joebritt/luma1/README.md

# Luma-1
A modern re-implementation of the classic LM-1 Drum Computer.

See Luma-1 User Guide [here](https://docs.google.com/document/d/1ew5HF2rmsIb3FmjGhrn8vHP6tWtrs4gh6rTB0z4mO2c/edit?usp=sharing).

See Luma-1 Firmware Architecture Overview [here](https://docs.google.com/document/d/17OXfVWuMG1HZEo0KaN4xHhIkEzbQIpoH/edit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).

<p align="middle">
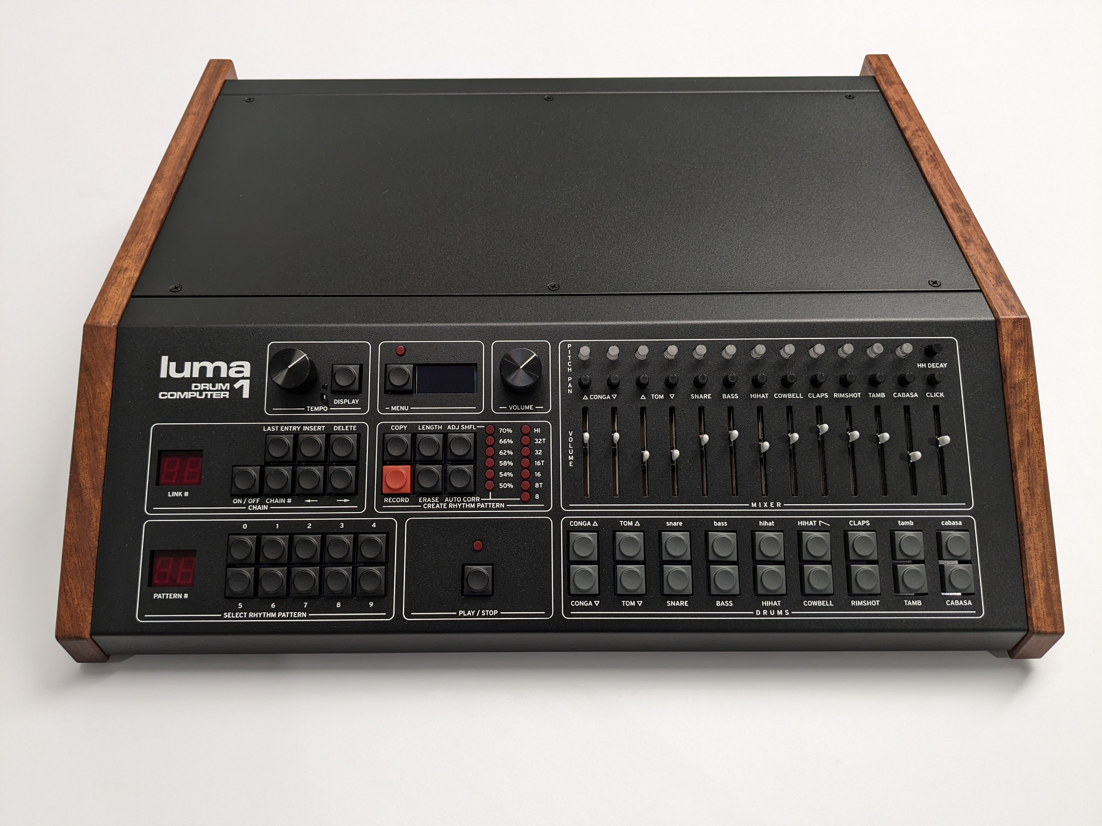
[picture p1: Luma-1 Pics/Luma-1_Bubinga_Front.jpg]
Luma-1
  
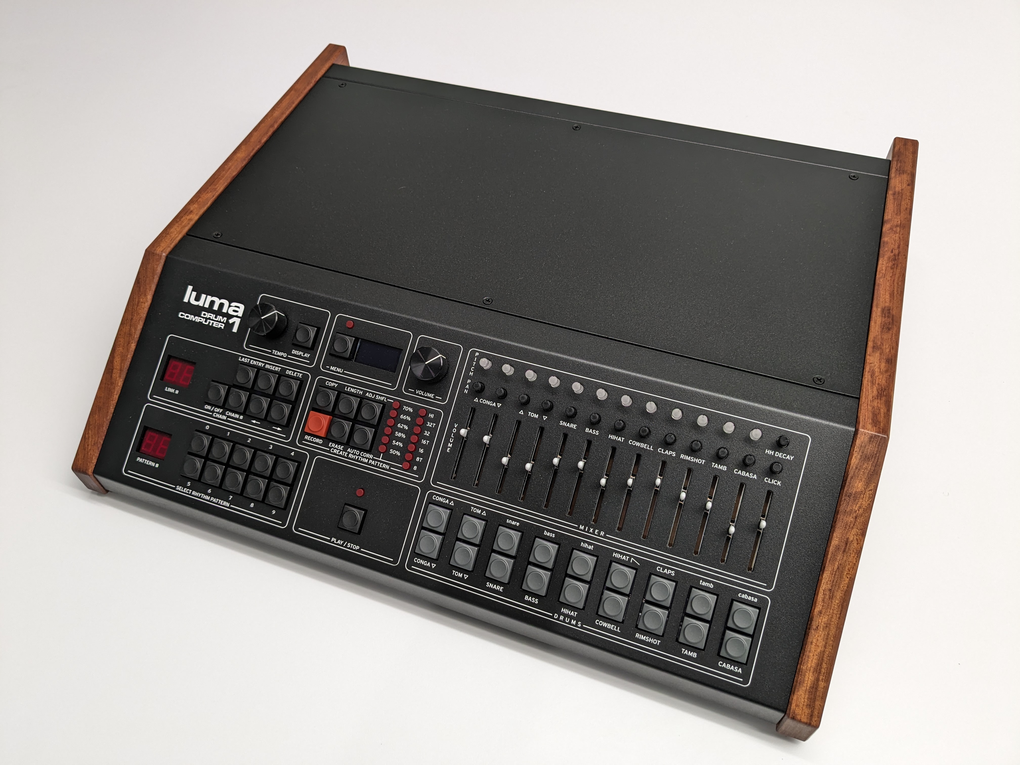
[picture p2: Luma-1 Pics/Luma-1_Bubinga_right.jpg]
Luma-1
  
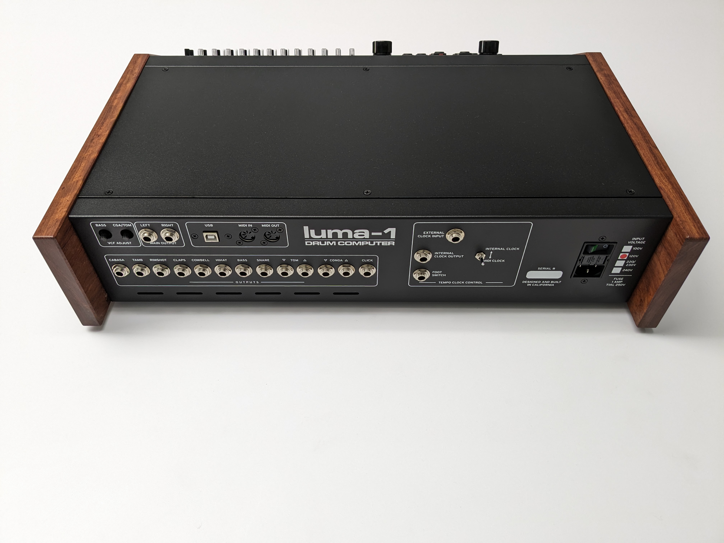
[picture p3: Luma-1 Pics/Luma-1_Bubinga_Rear.jpg]
Luma-1
  
</p>
