joebritt/luma1/Luma-1 Pics/Luma-1_Bubinga_Open.jpg

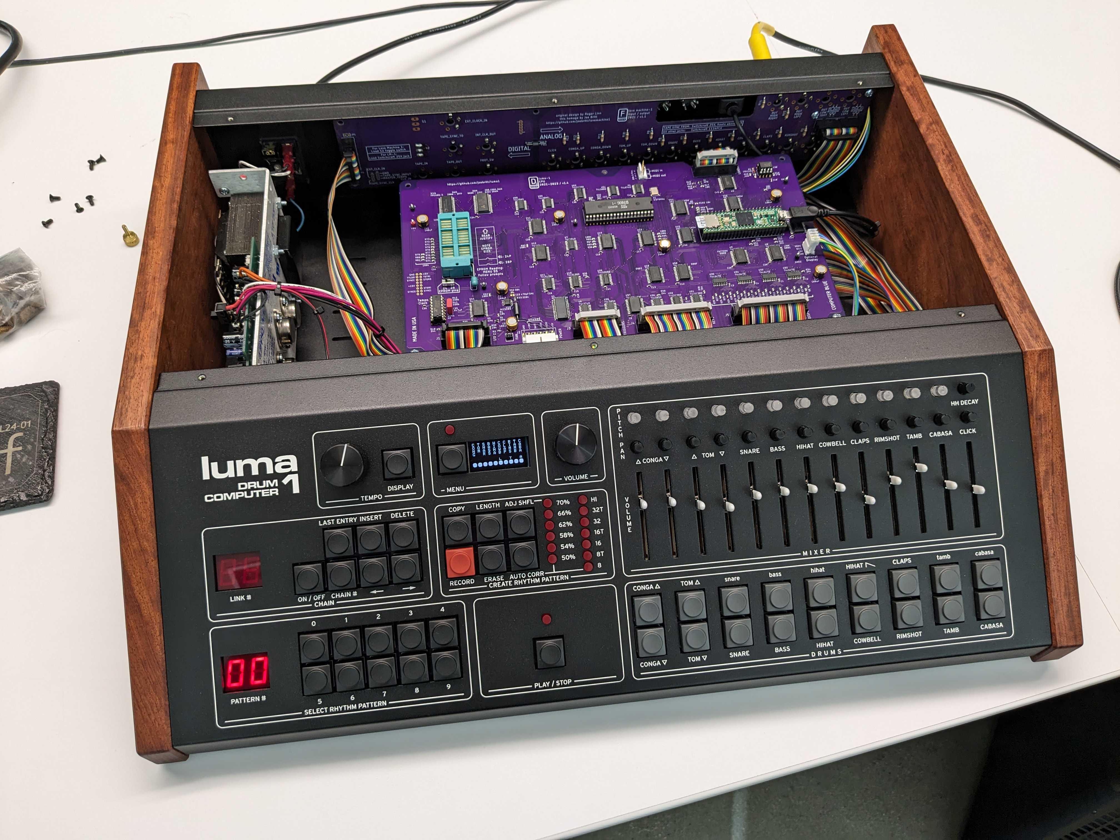
Luma-1 Pics/Luma-1_Bubinga_Open.jpg
