joebritt/luma1/Luma-1 Pics/Luma-1_LM-1_Together.jpg

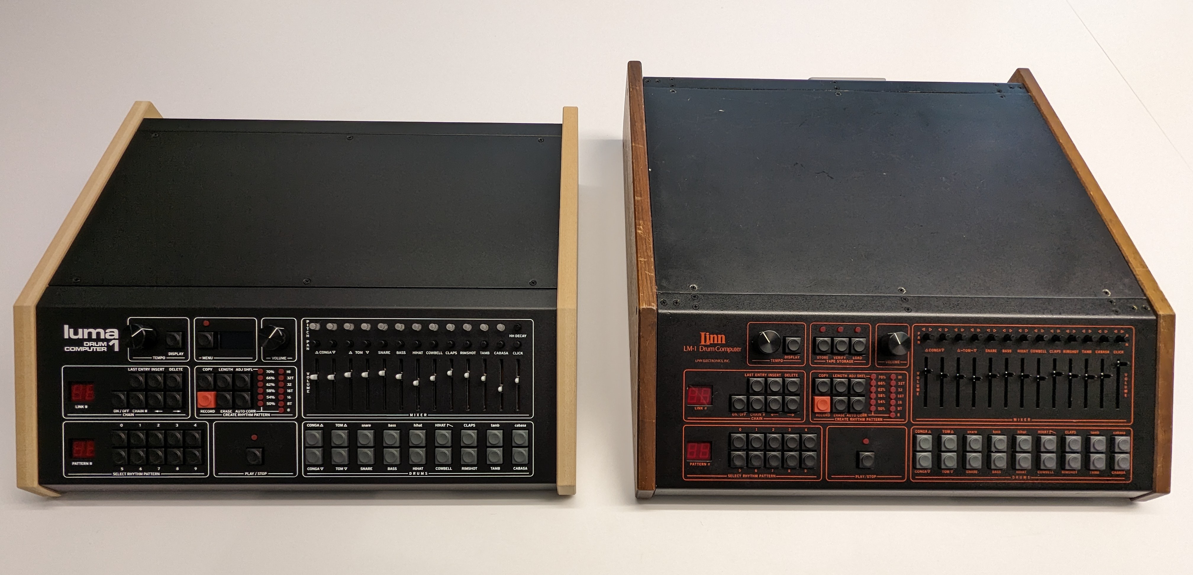
Luma-1 Pics/Luma-1_LM-1_Together.jpg
