joebritt/luma1/Schematics/luma-1_release_17Jan2024/luma1_D2_41.pdf

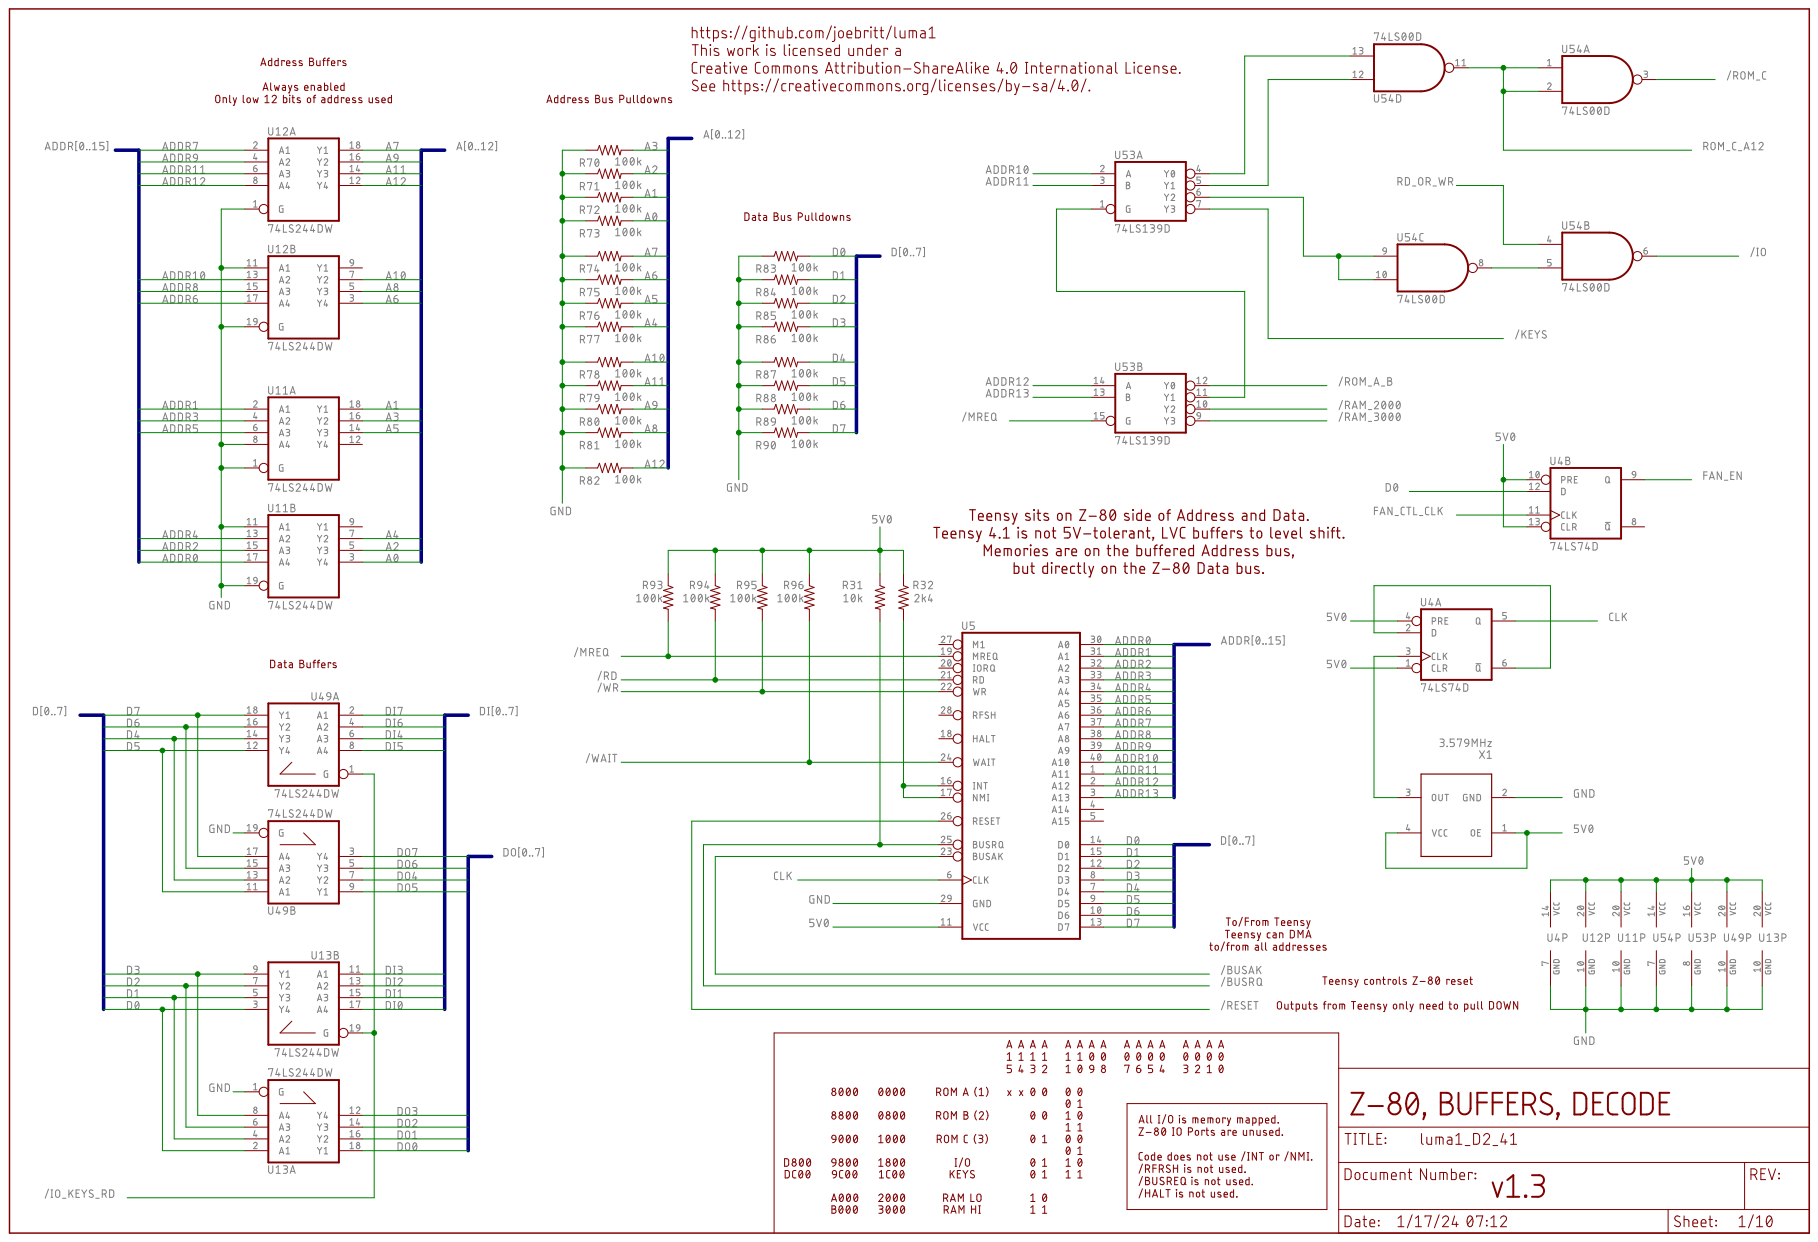
[picture p7: page 1]

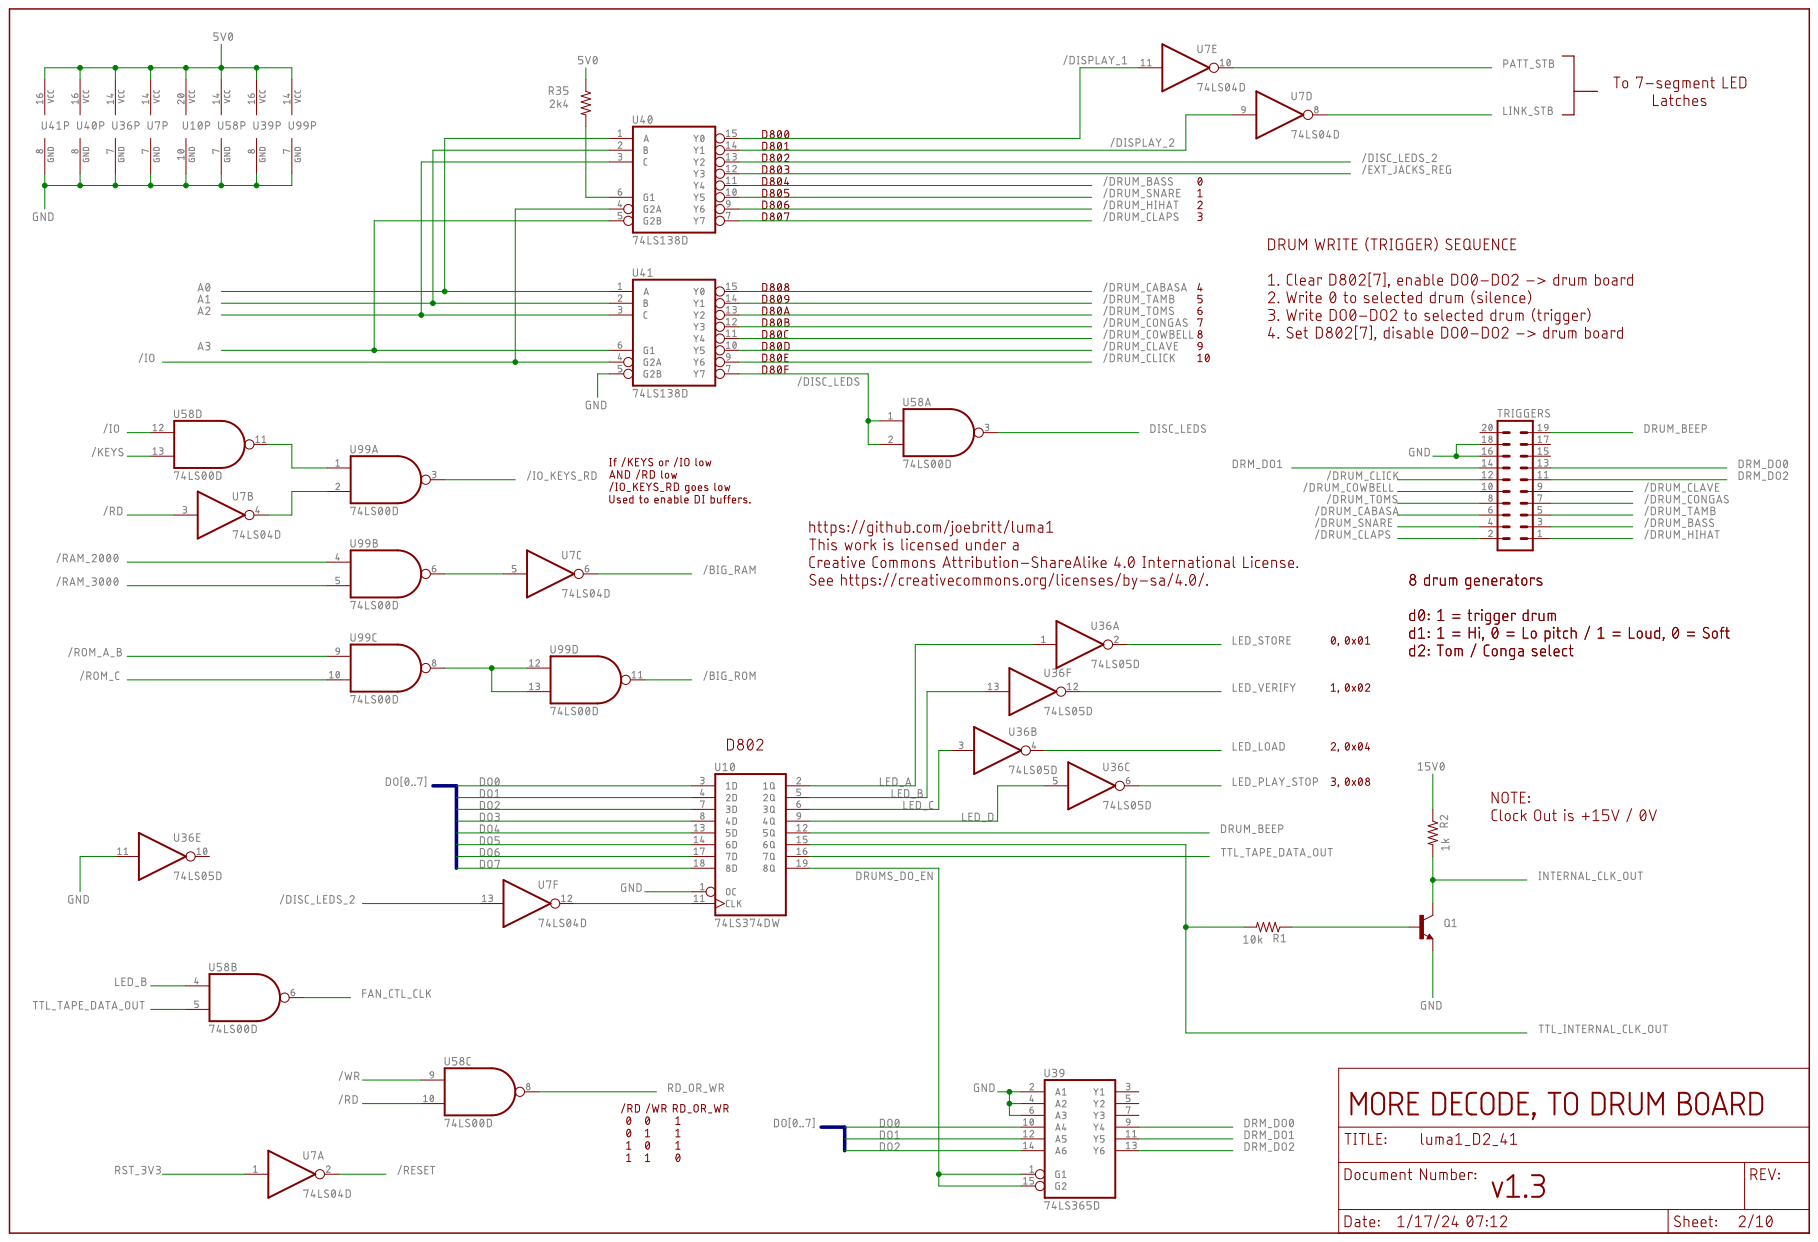
[picture p8: page 2]

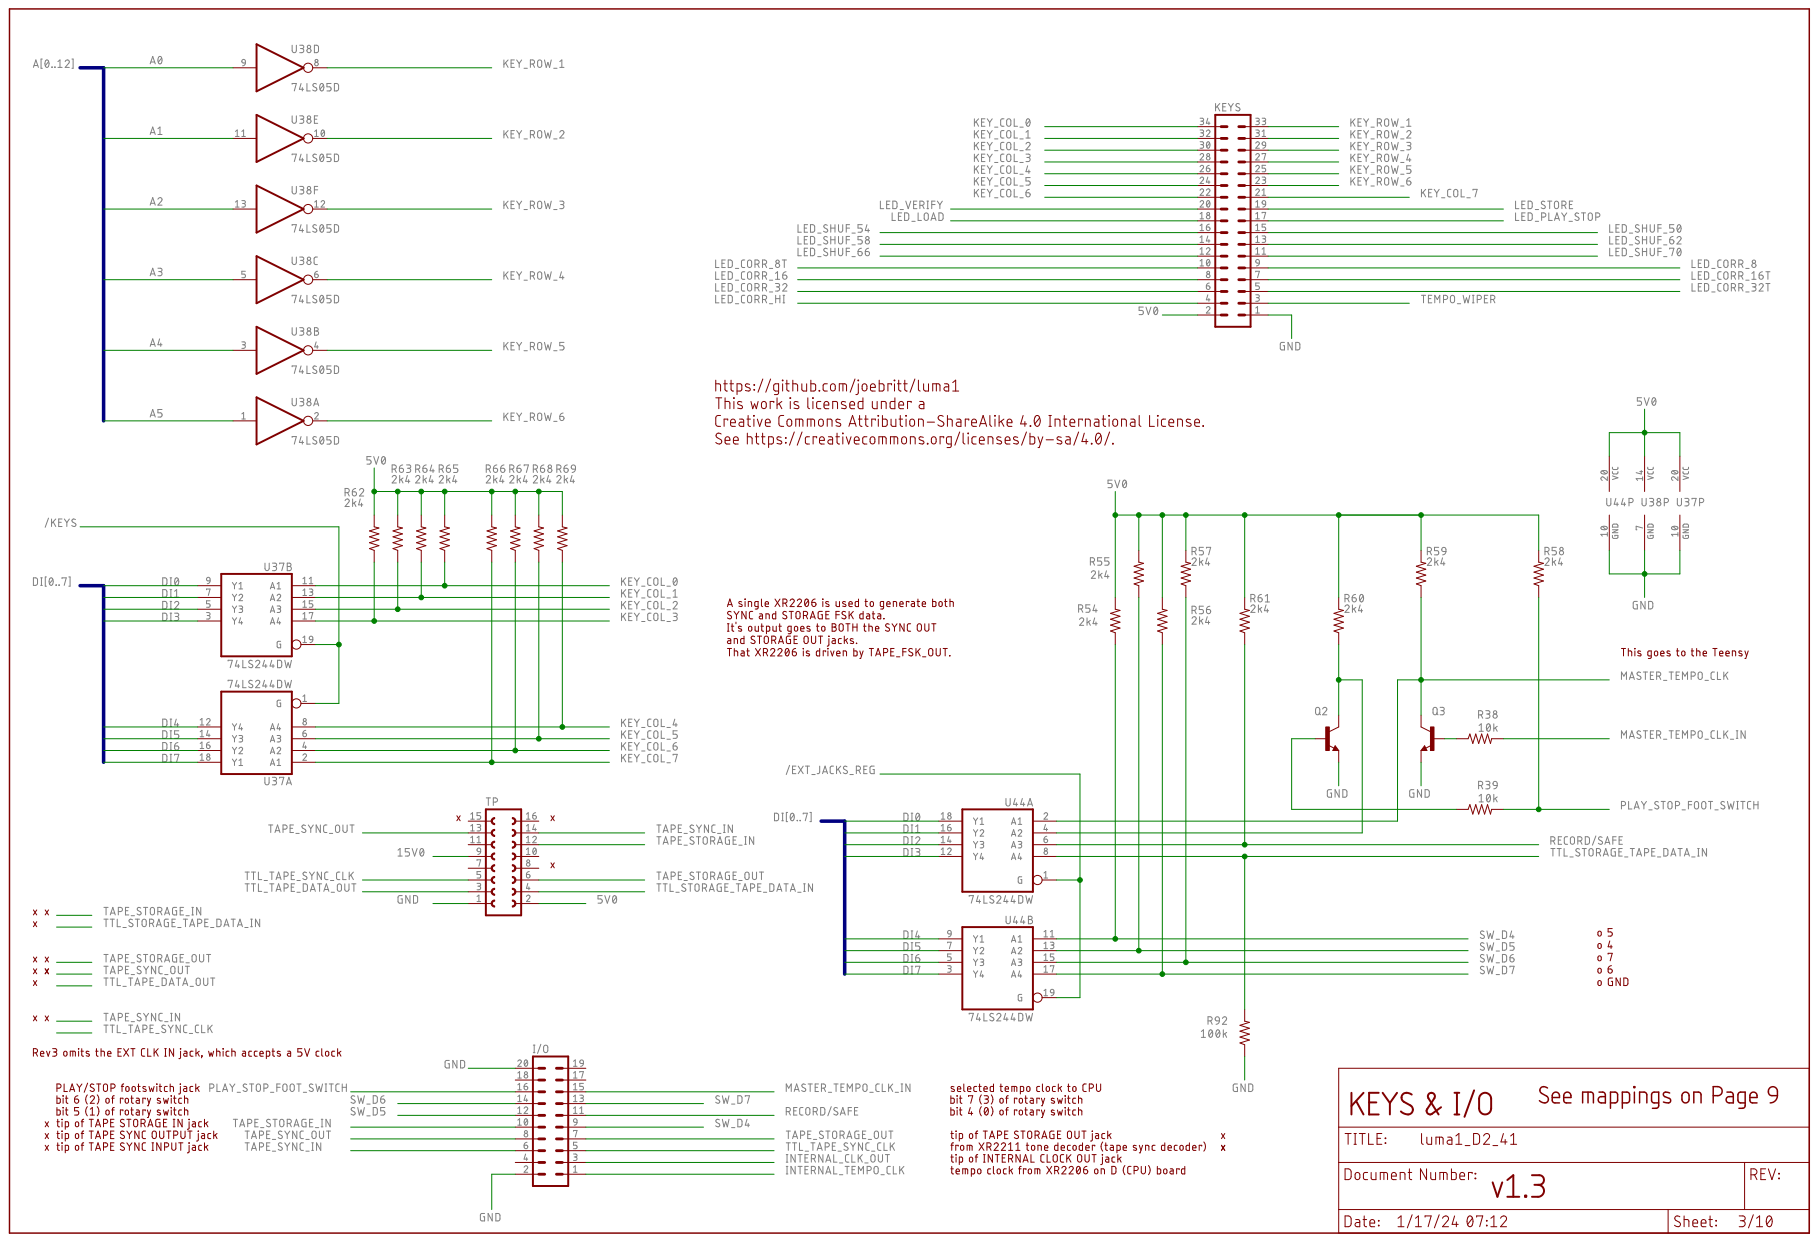
[picture p9: page 3]

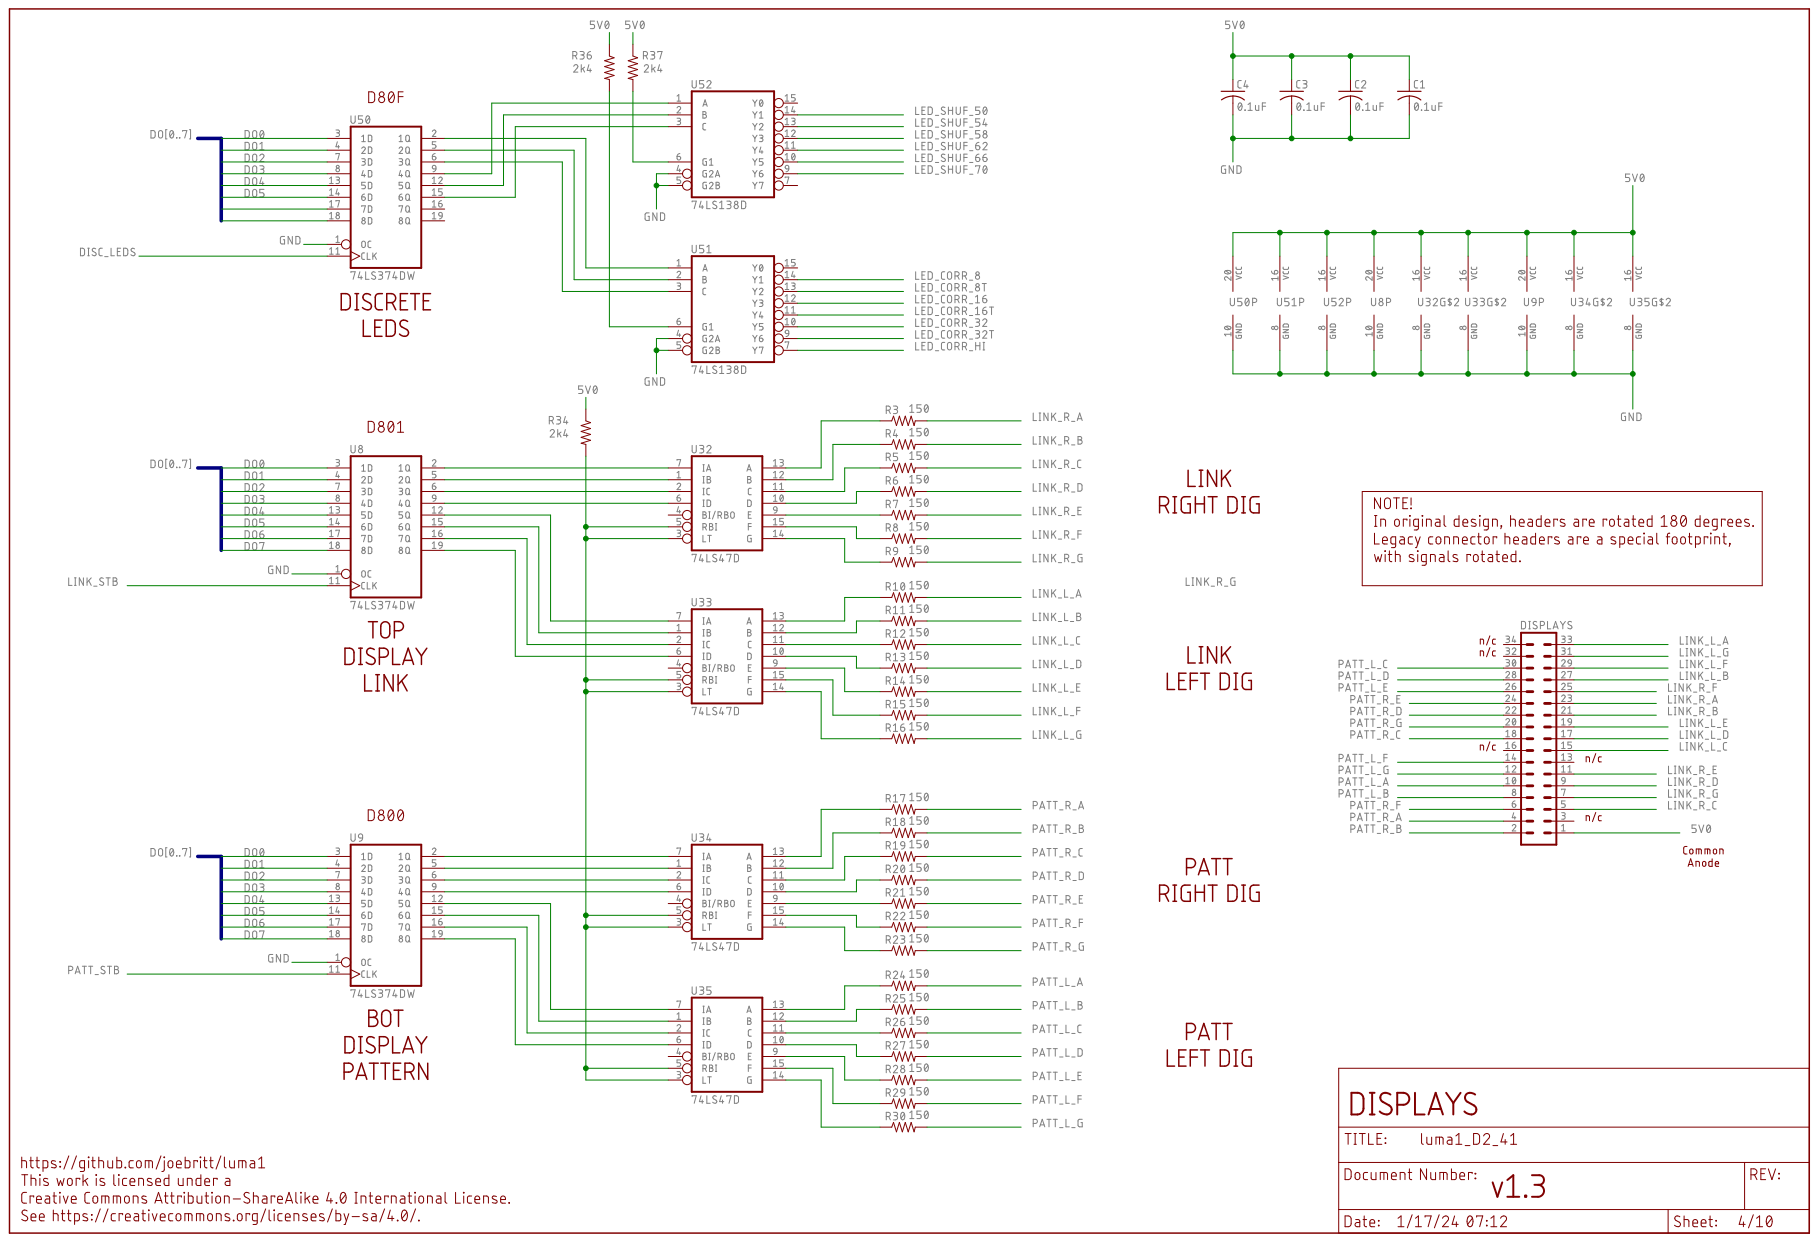
[picture p10: page 4]

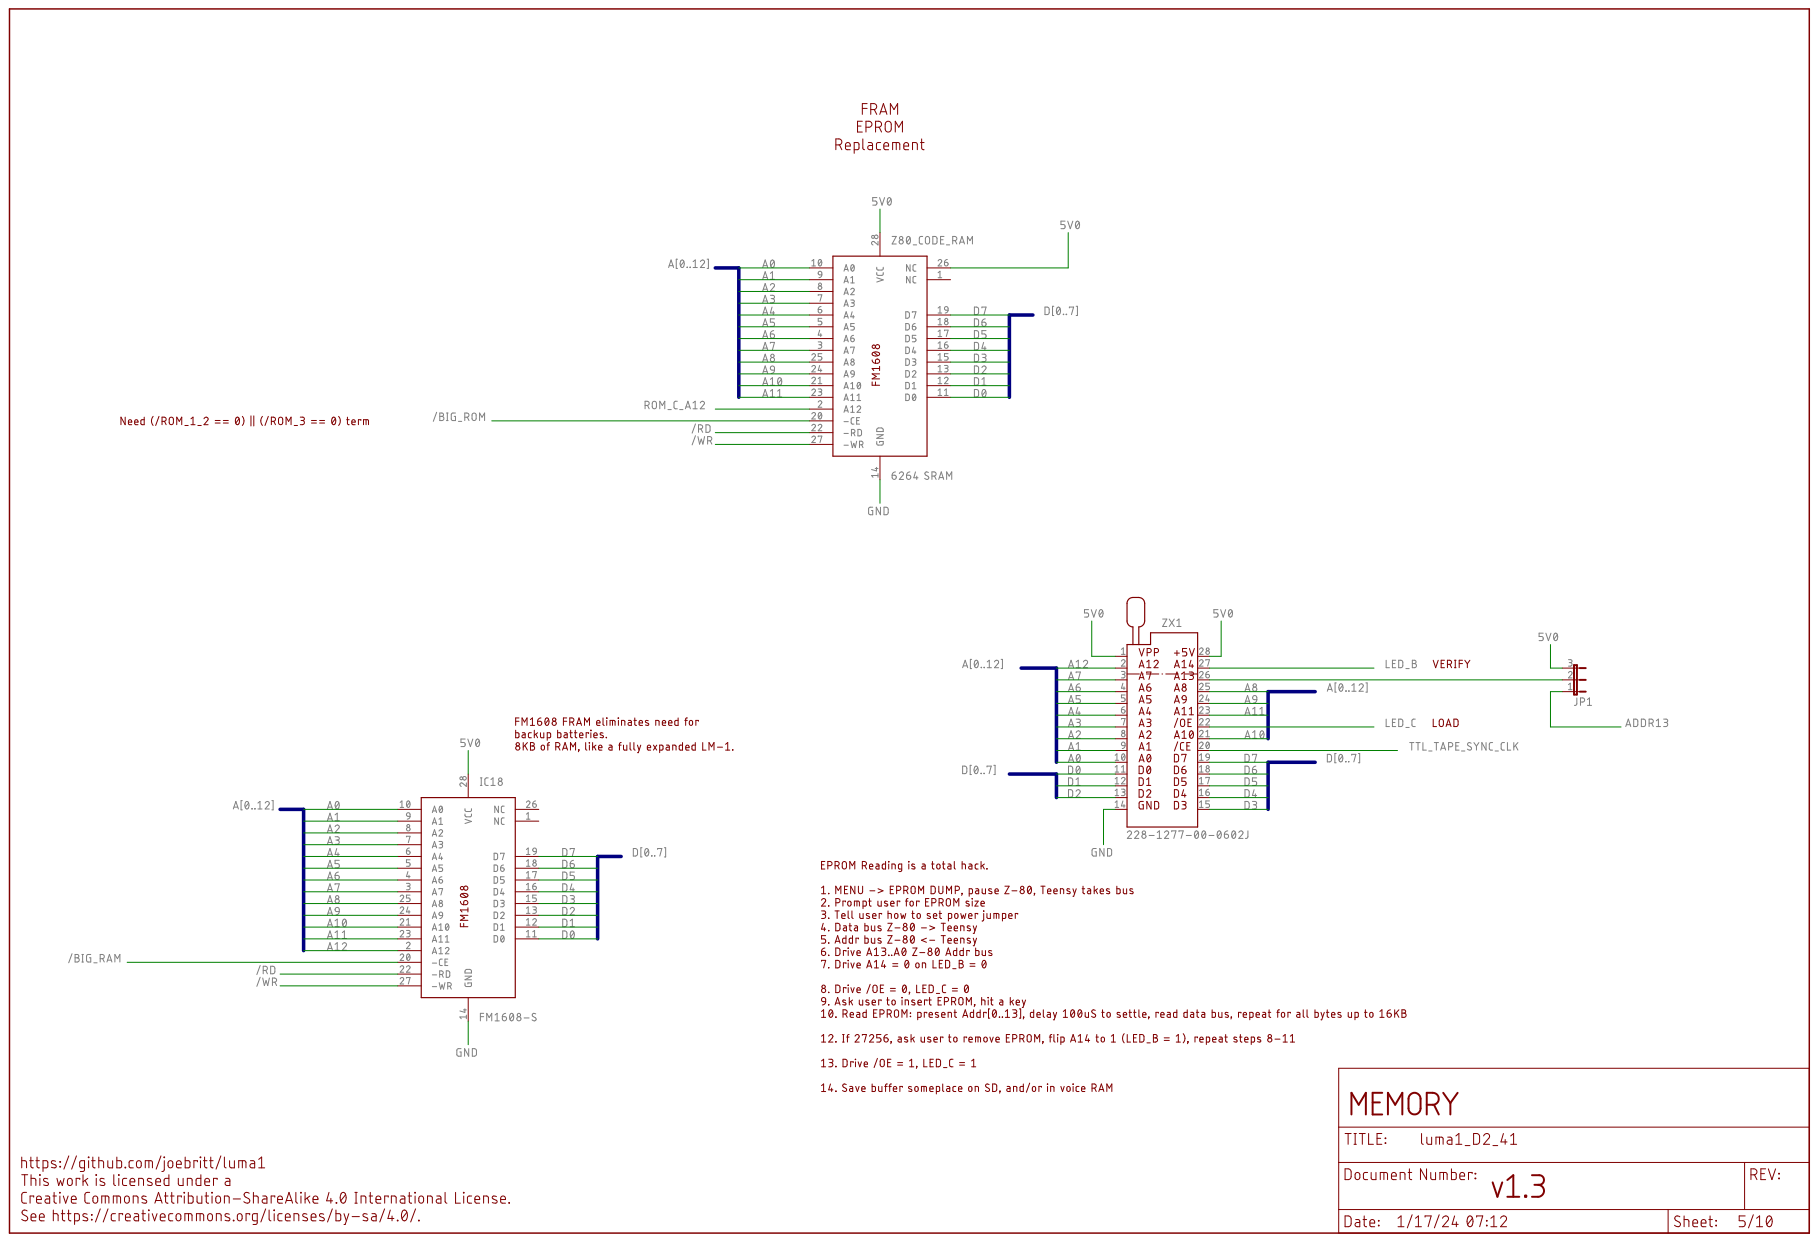
[picture p11: page 5]

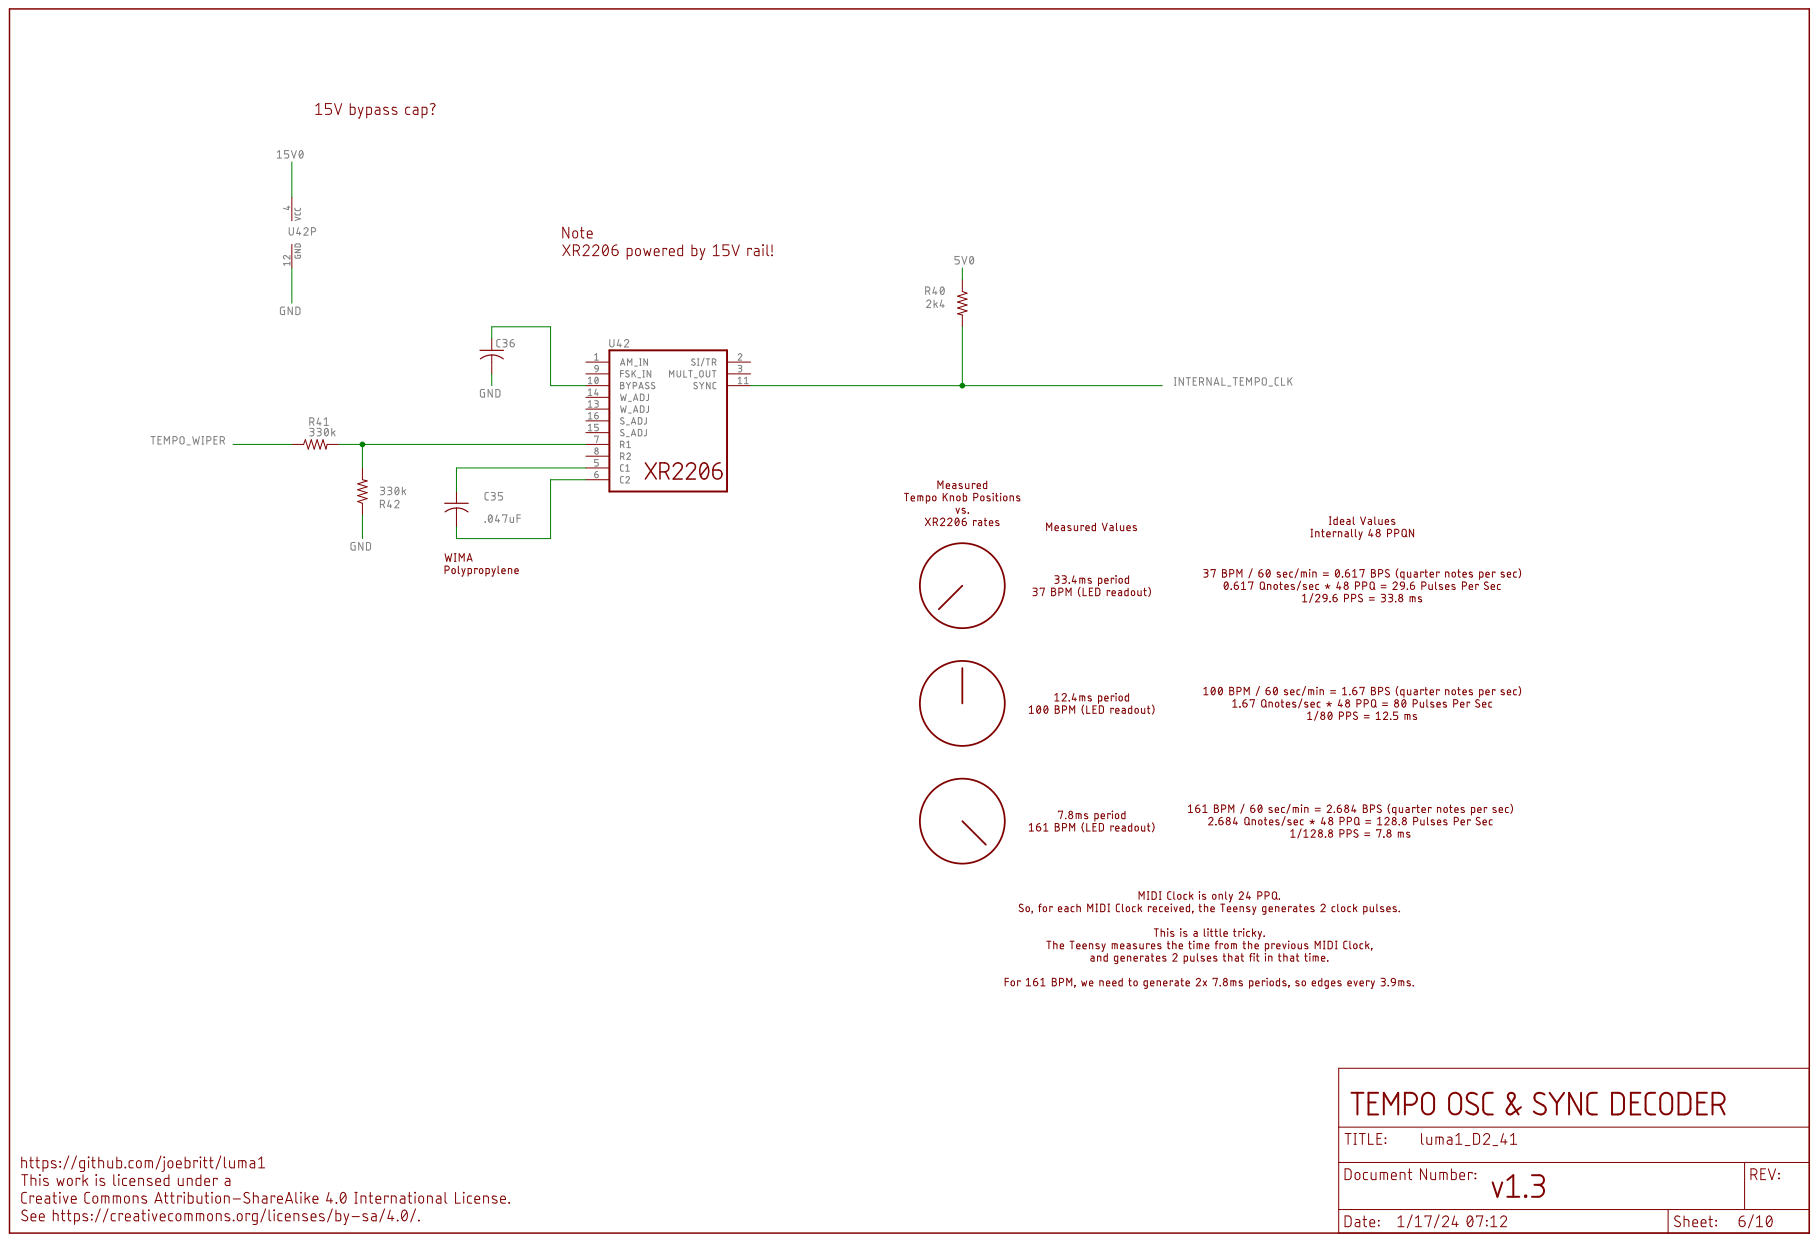
[picture p12: page 6]

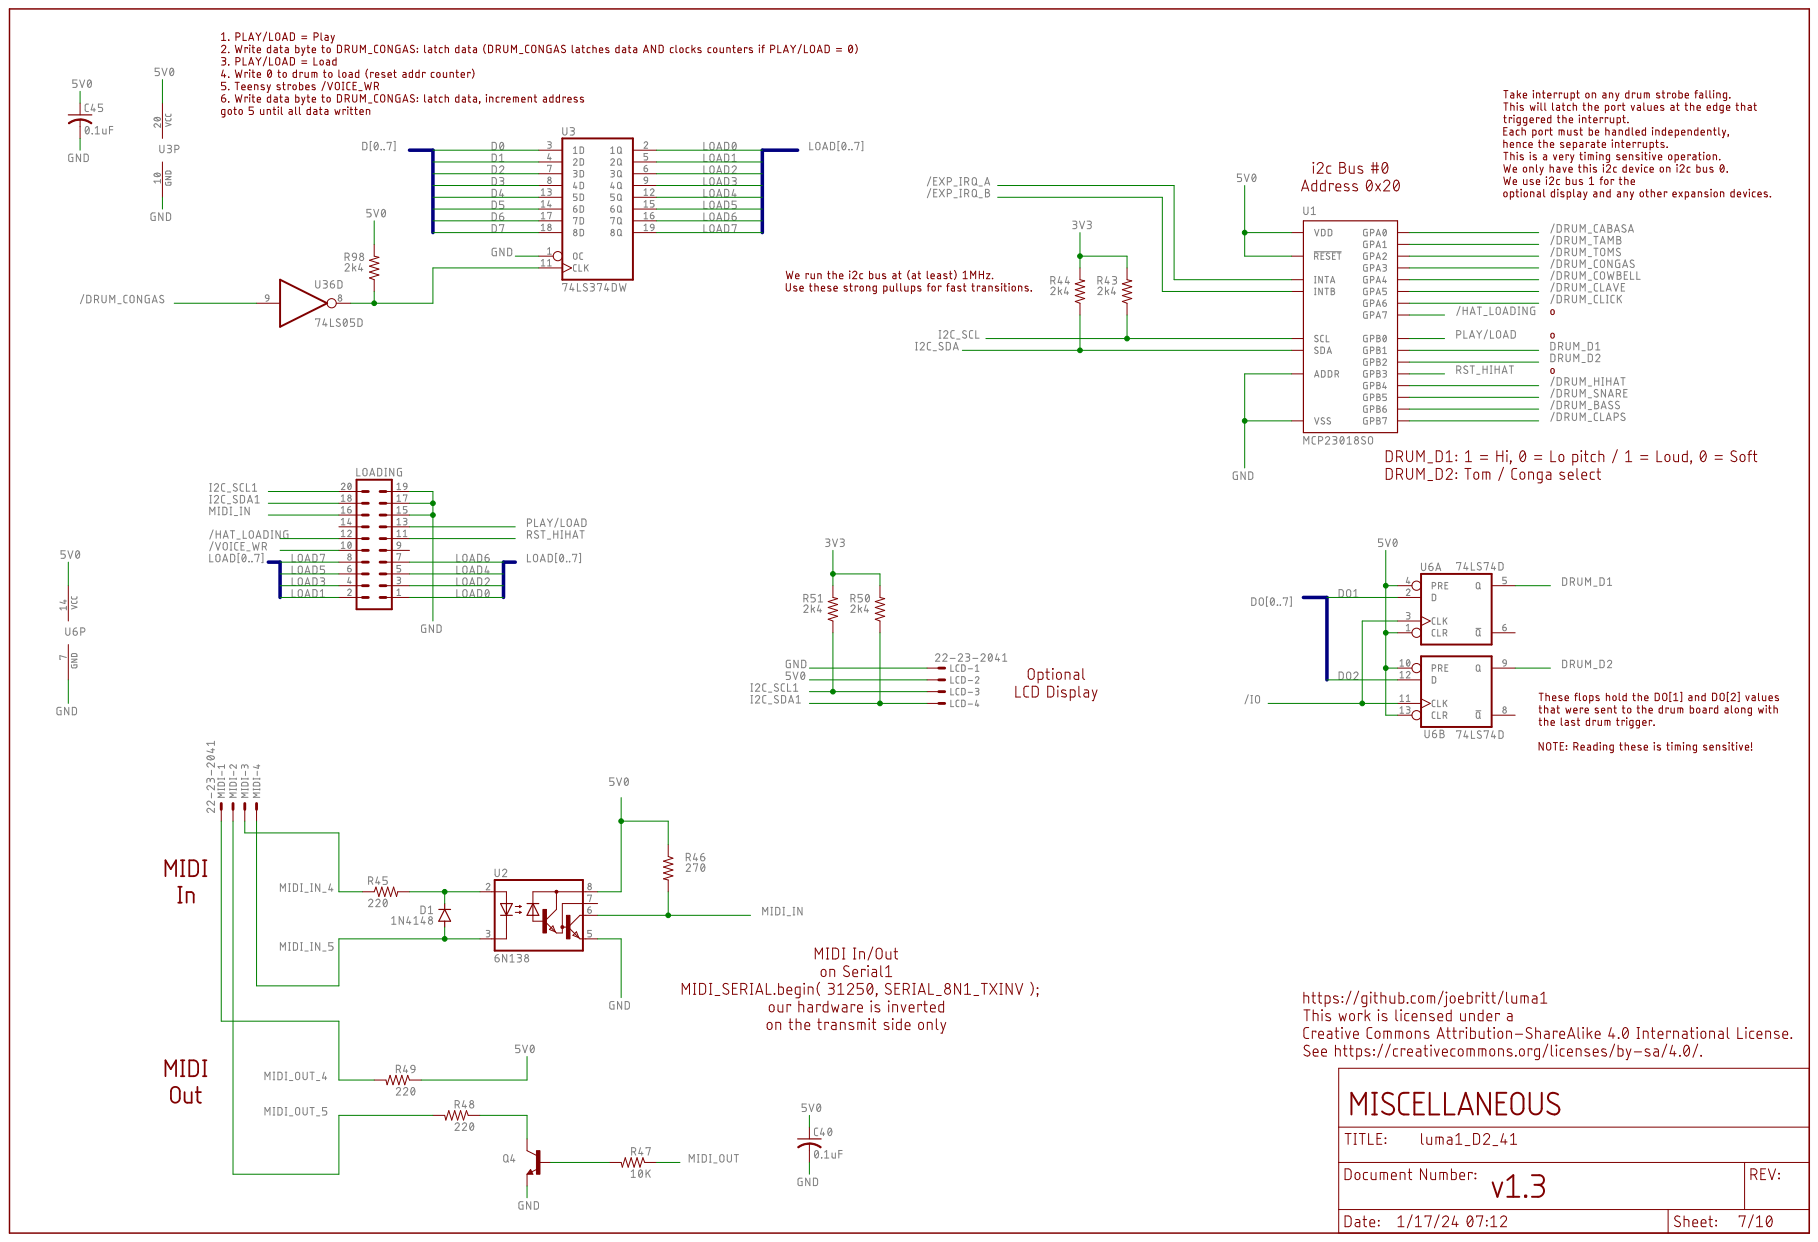
[picture p13: page 7]

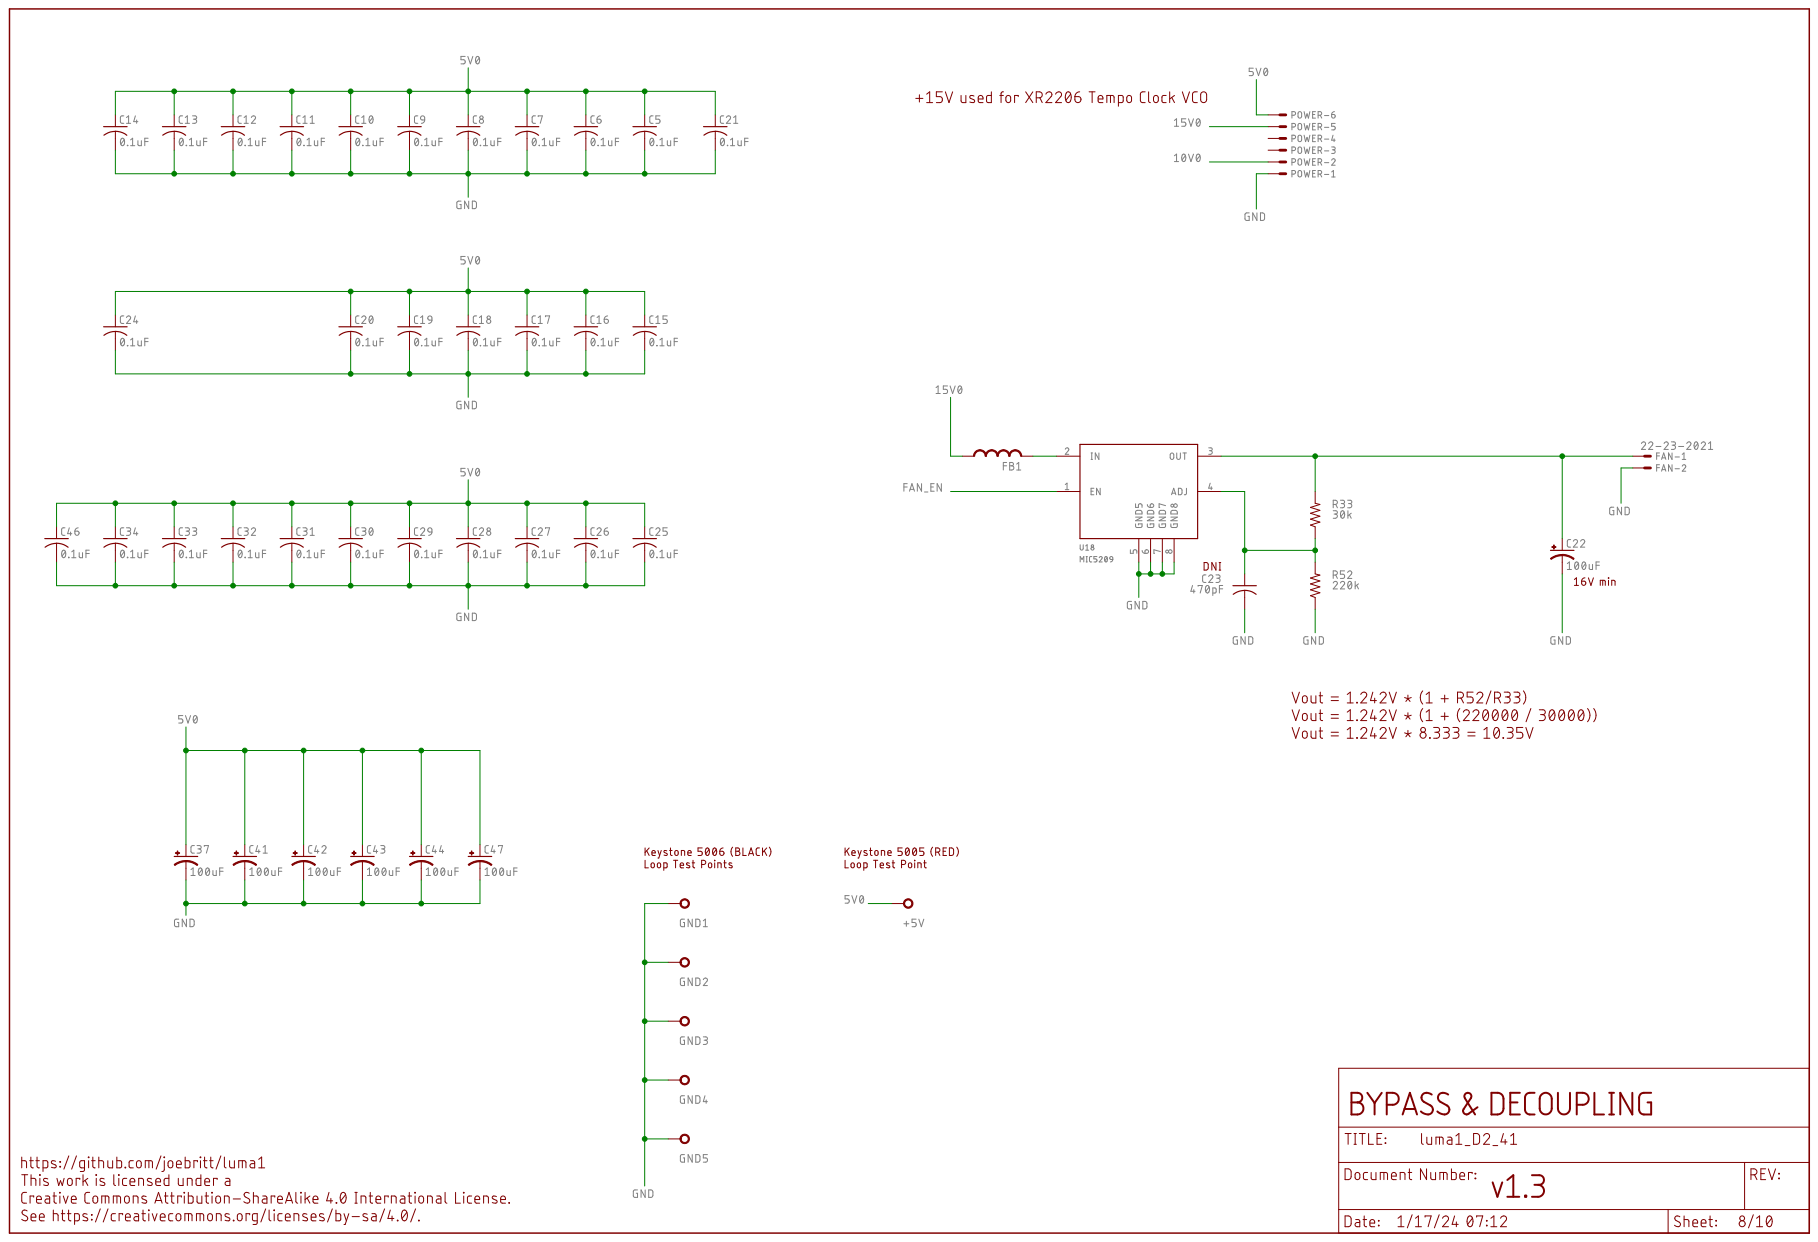
[picture p14: page 8]

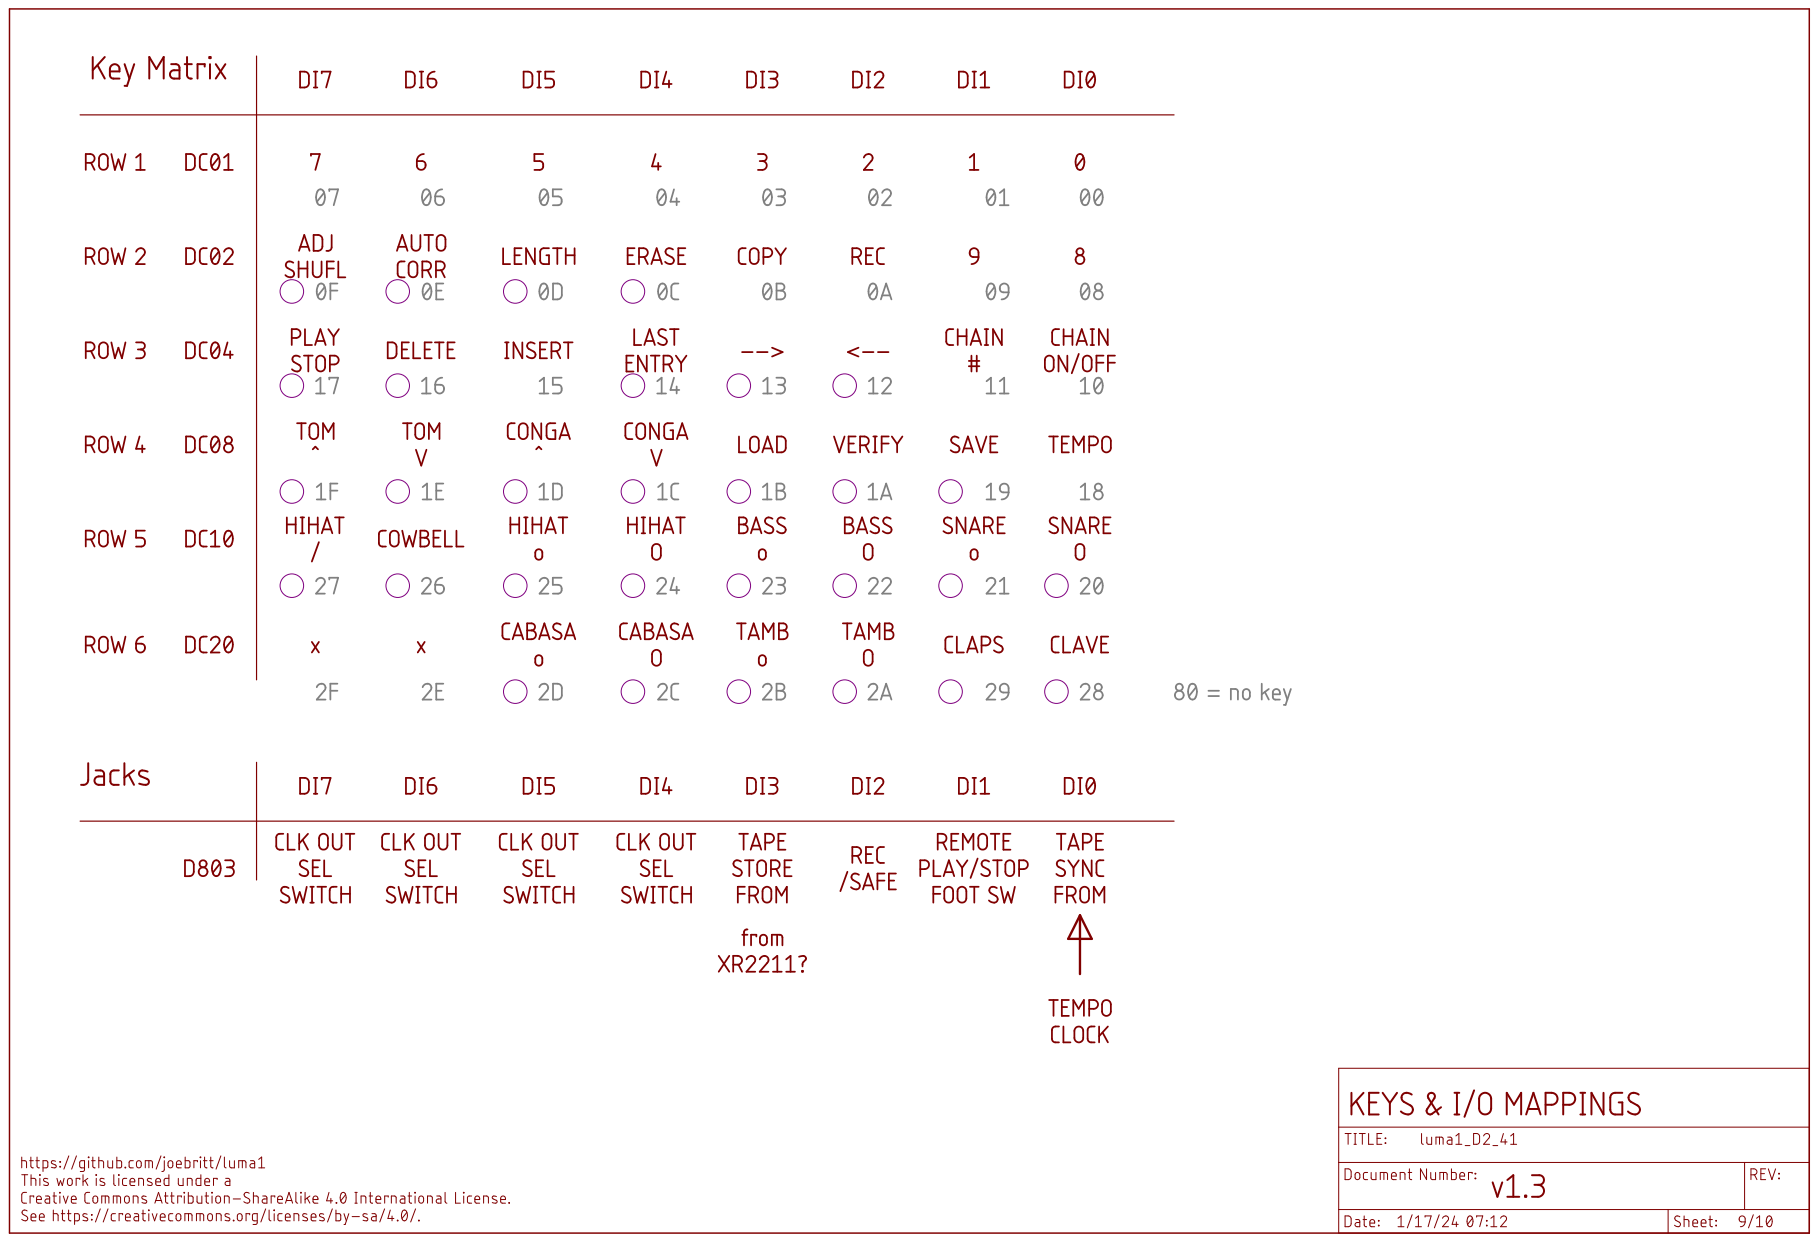
[picture p15: page 9]

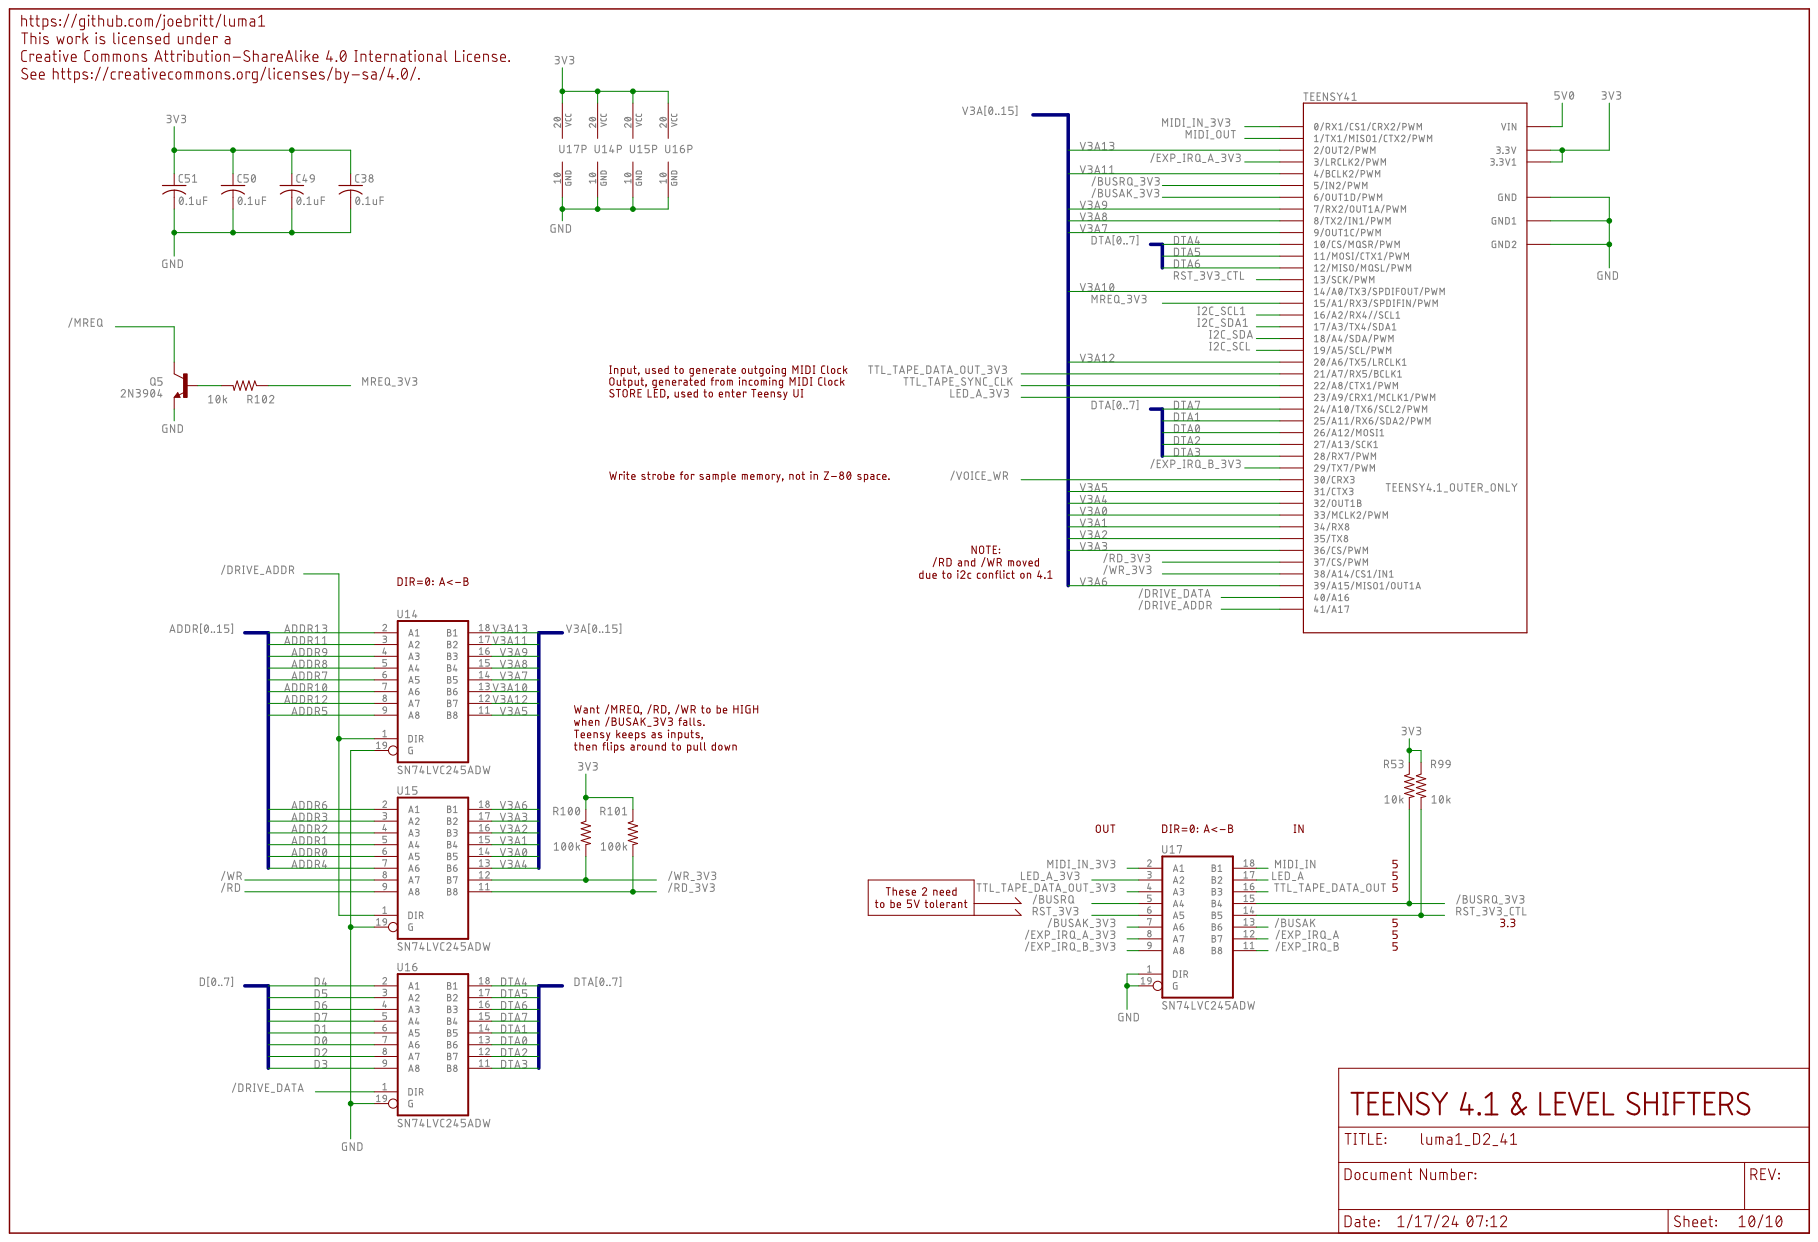
[picture p16: page 10]
