joebritt/luma1/Schematics/luma-1_release_17Jan2024/luma1_A.pdf

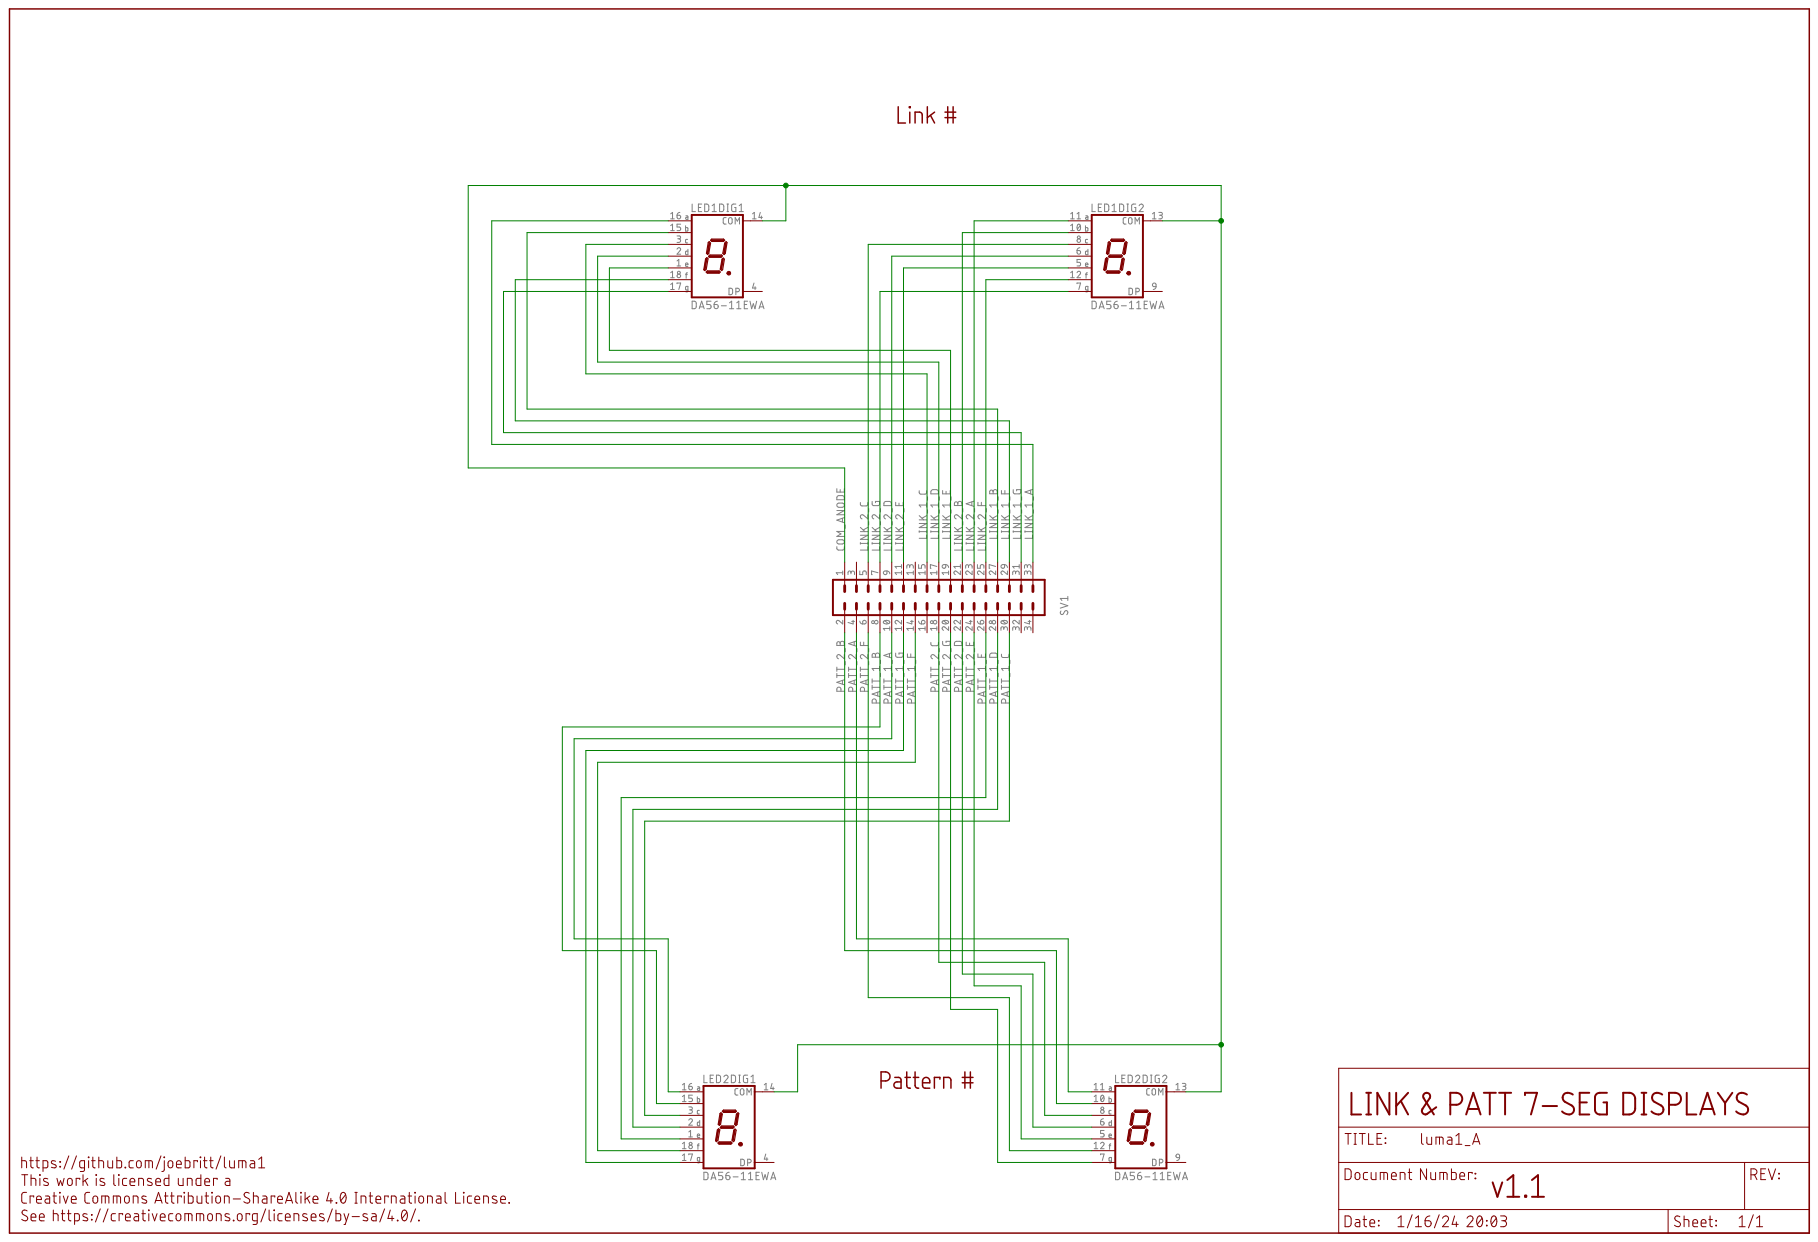
[picture p17: page 1]
