joebritt/luma1/Schematics/luma-1_release_17Jan2024/luma1_E.pdf

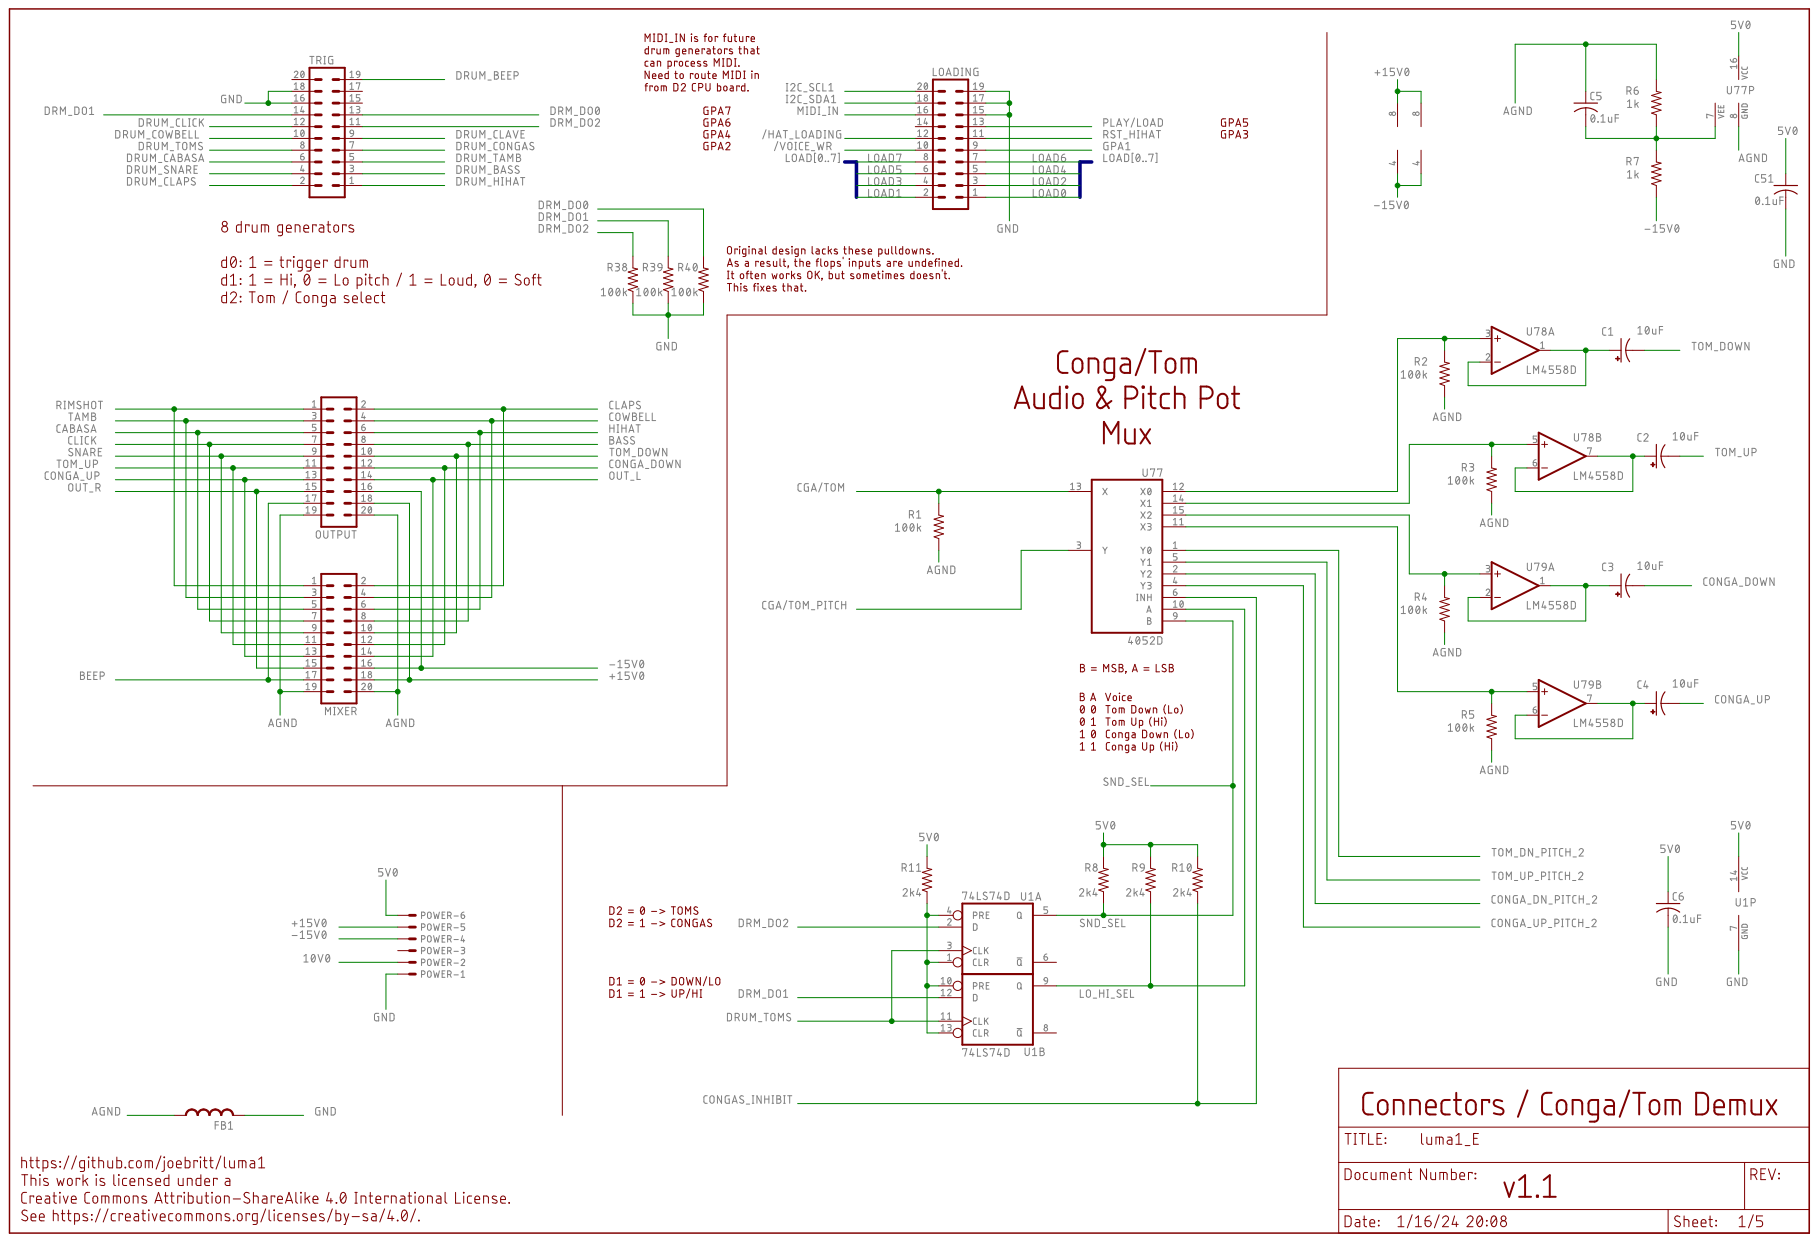
[picture p24: page 1]

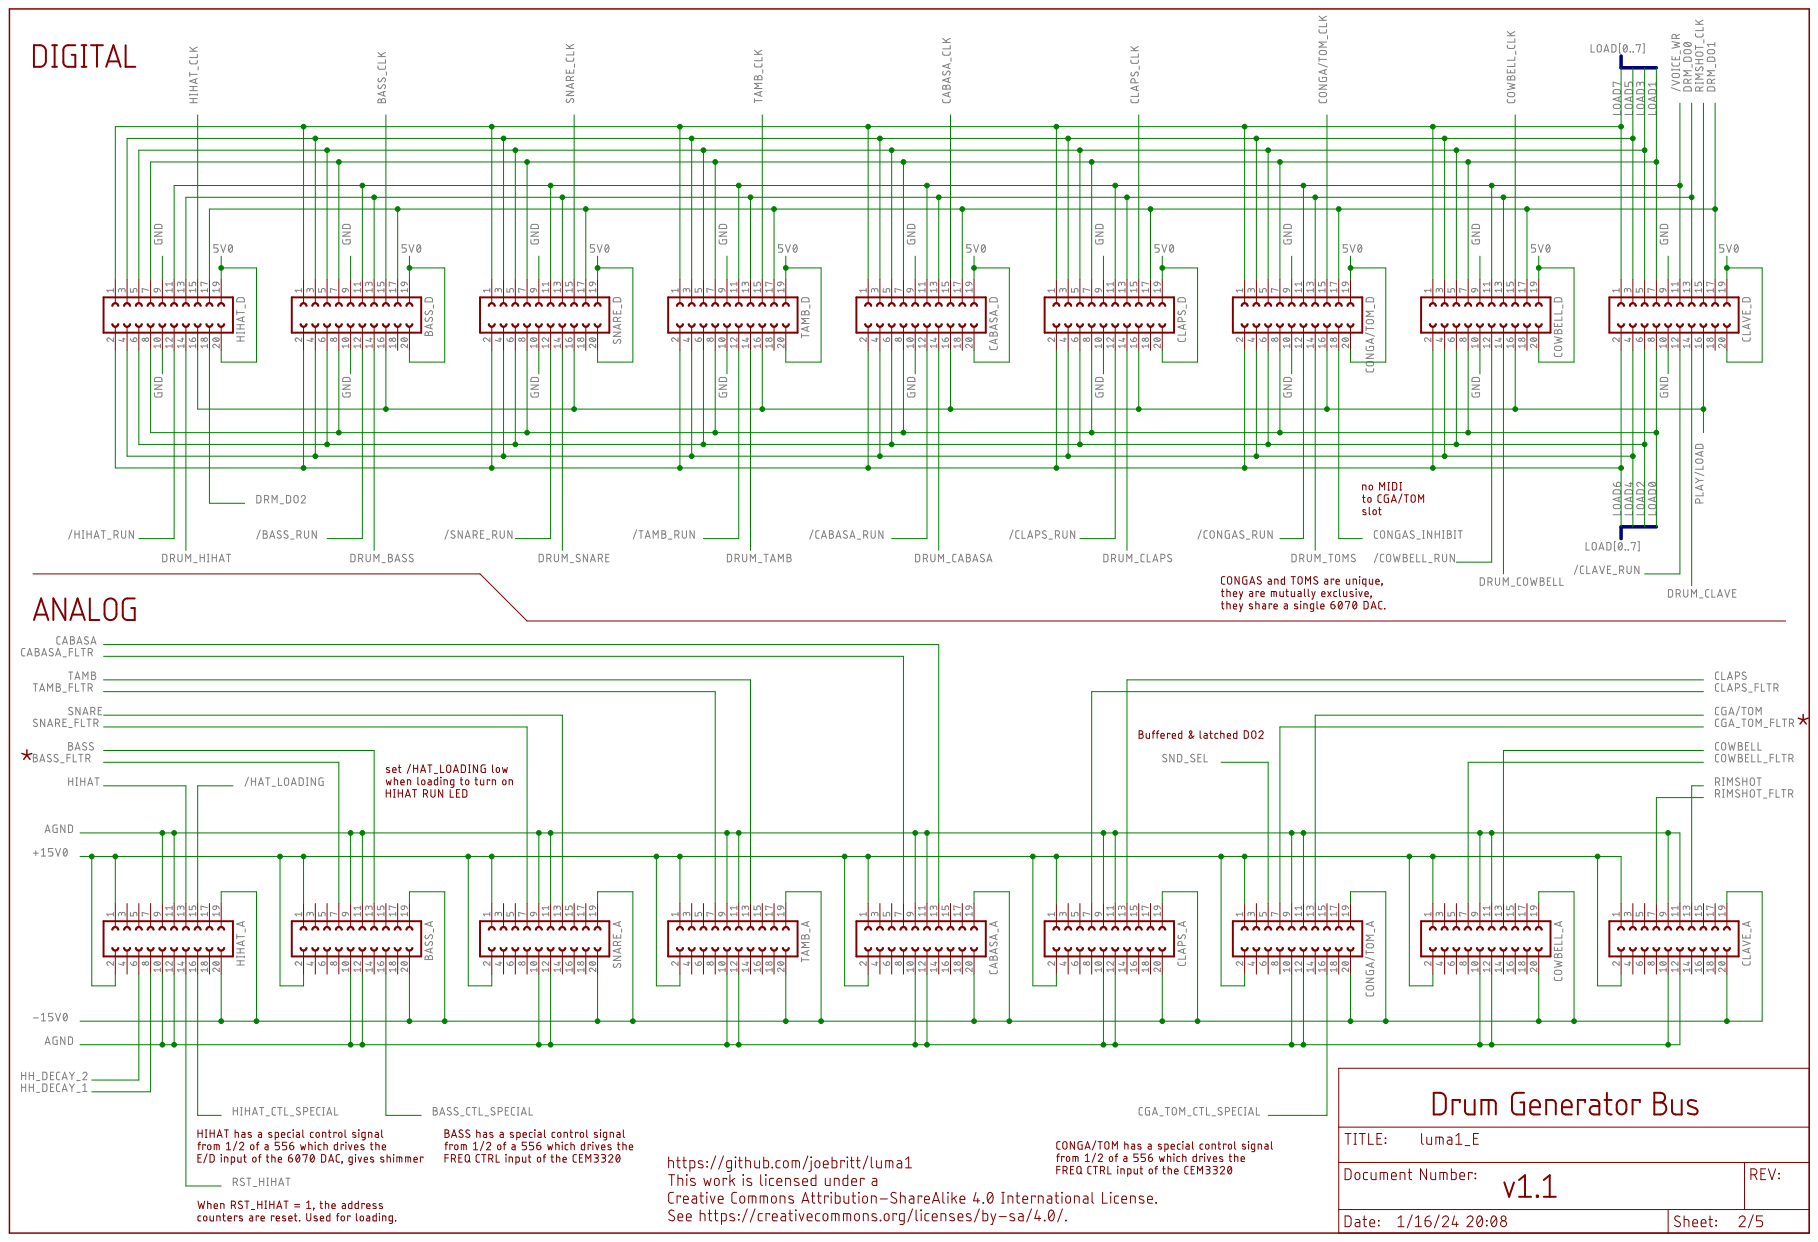
[picture p25: page 2]

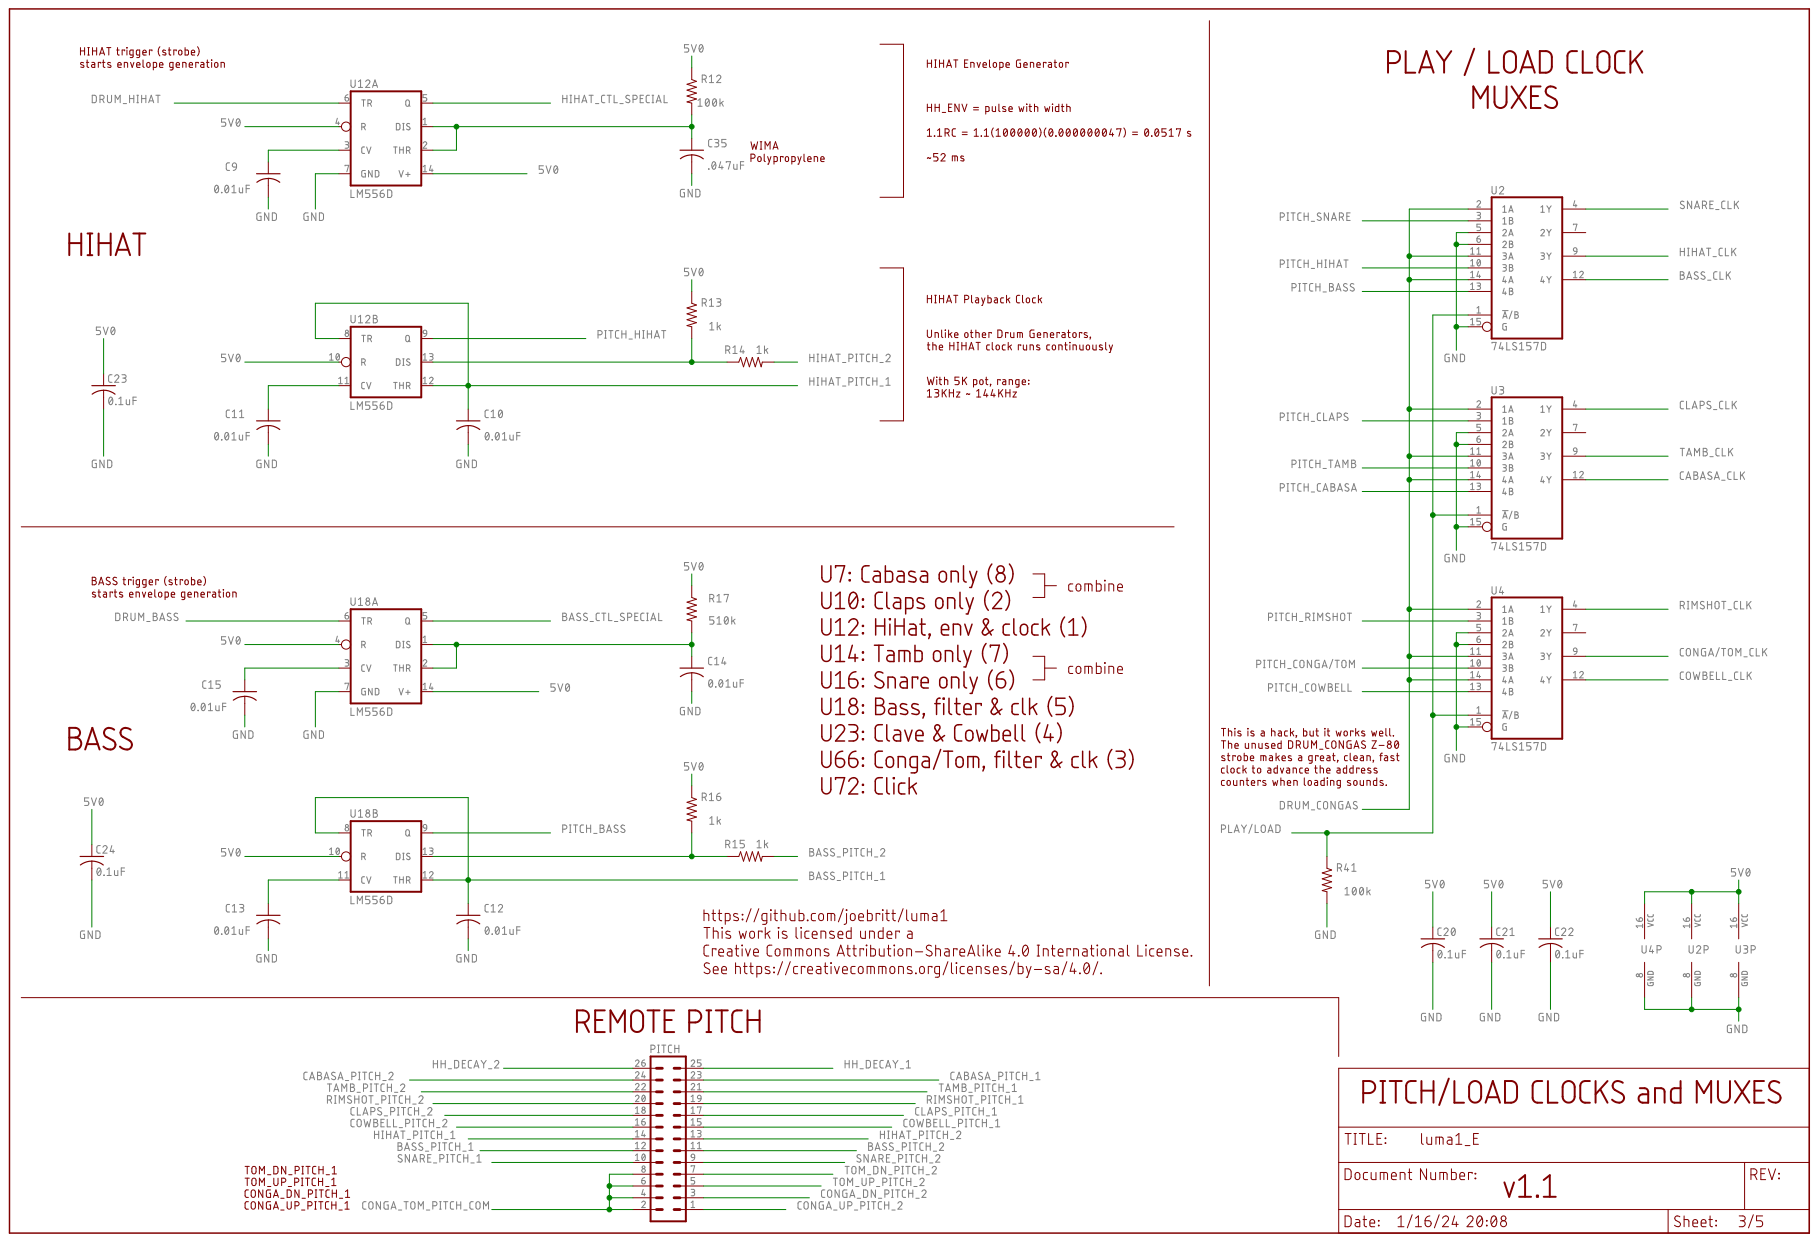
[picture p26: page 3]

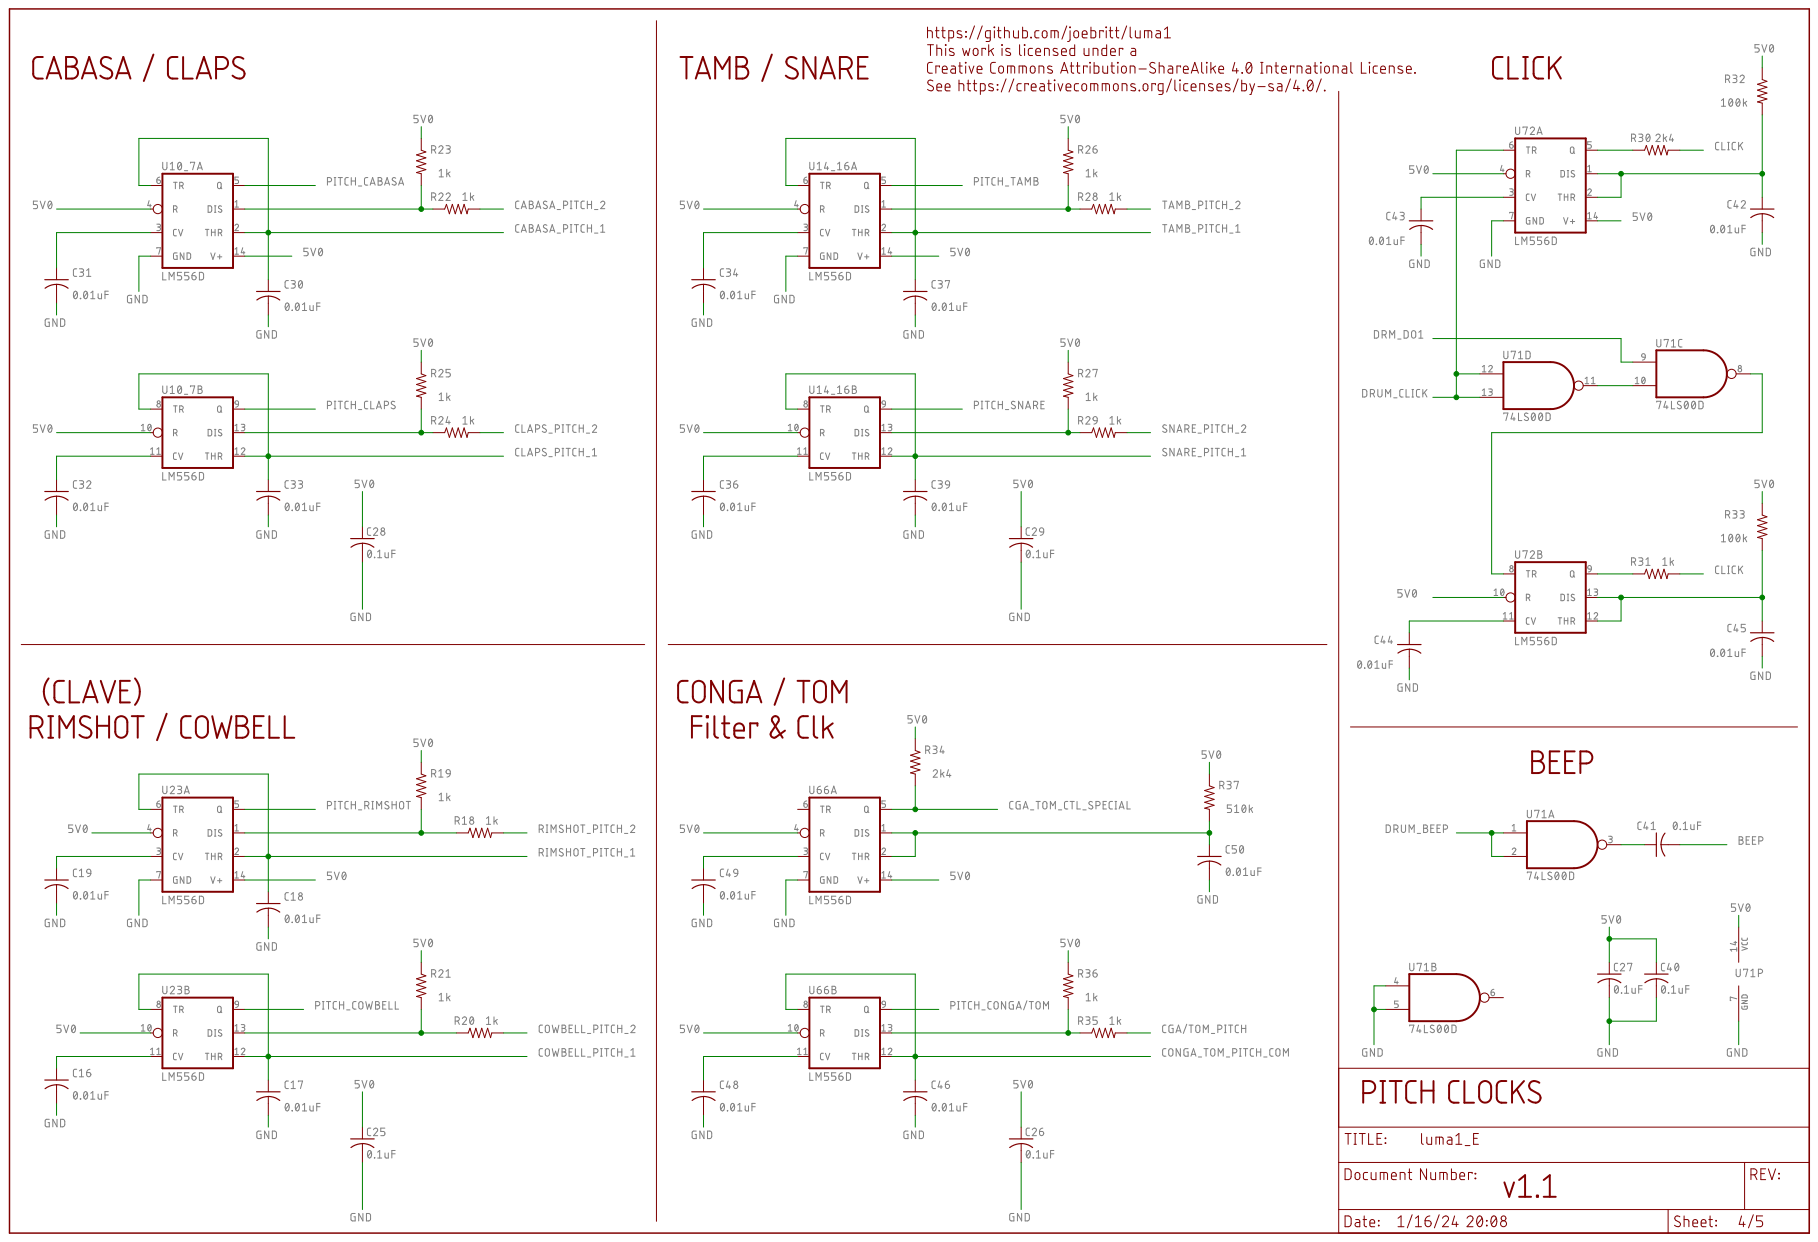
[picture p27: page 4]

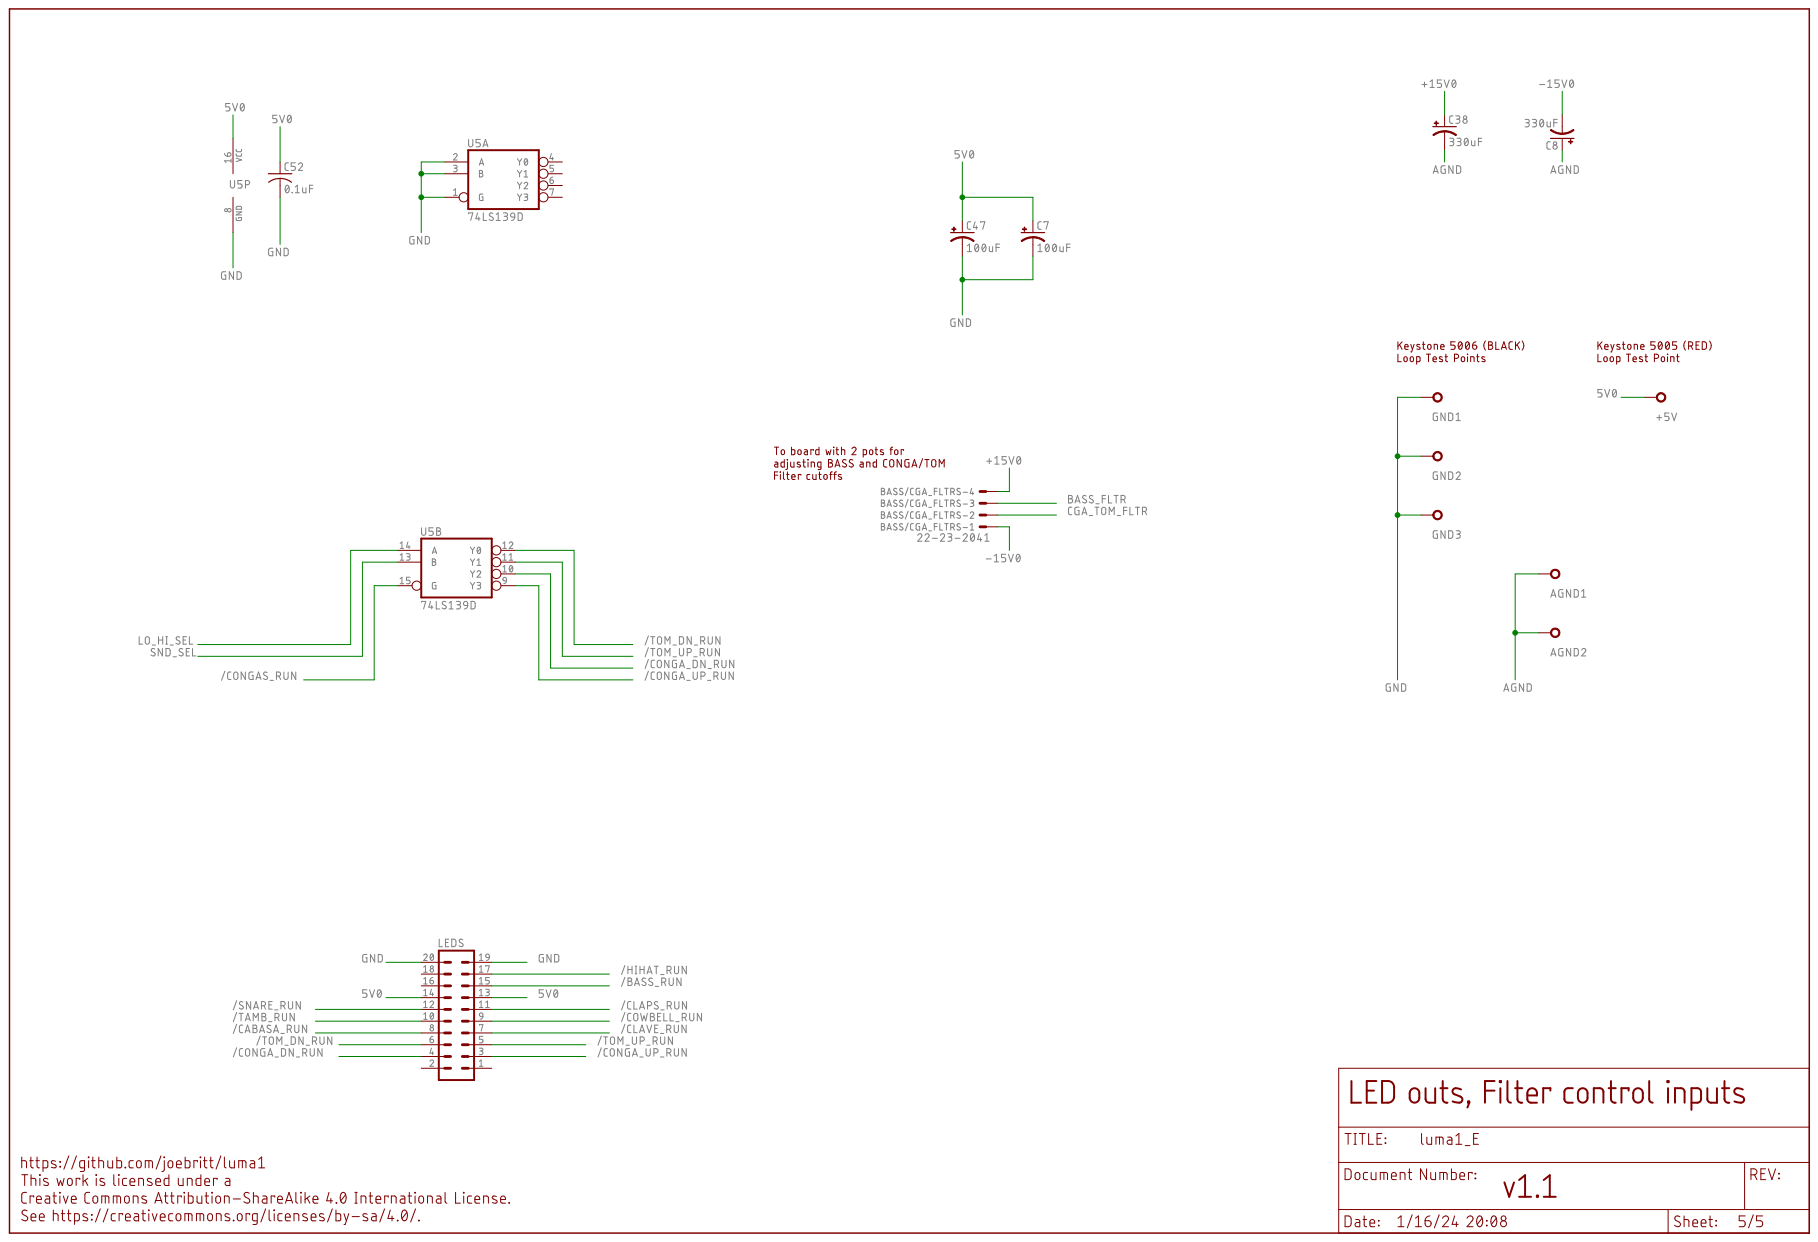
[picture p28: page 5]
