joebritt/luma1/Schematics/luma-1_release_17Jan2024/luma1_F.pdf

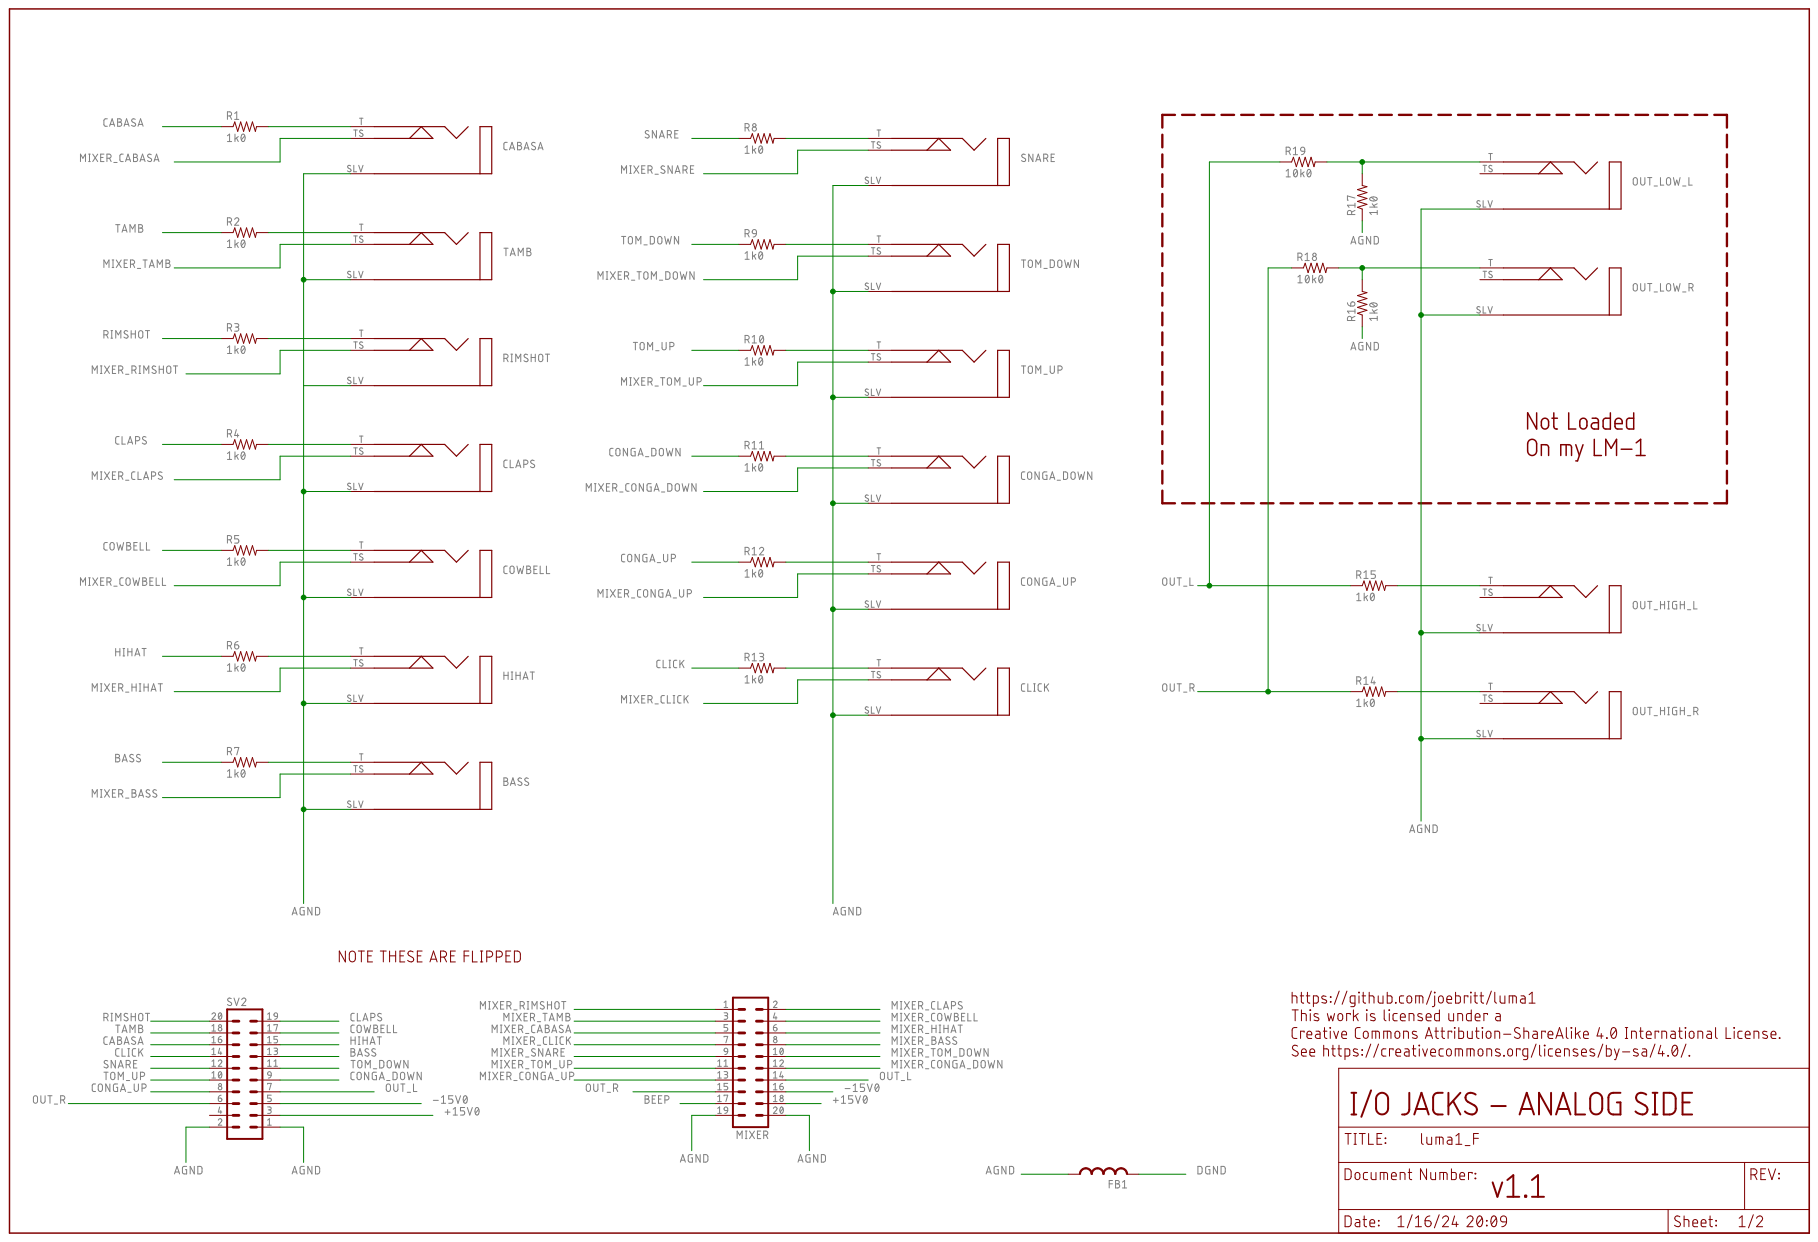
[picture p29: page 1]

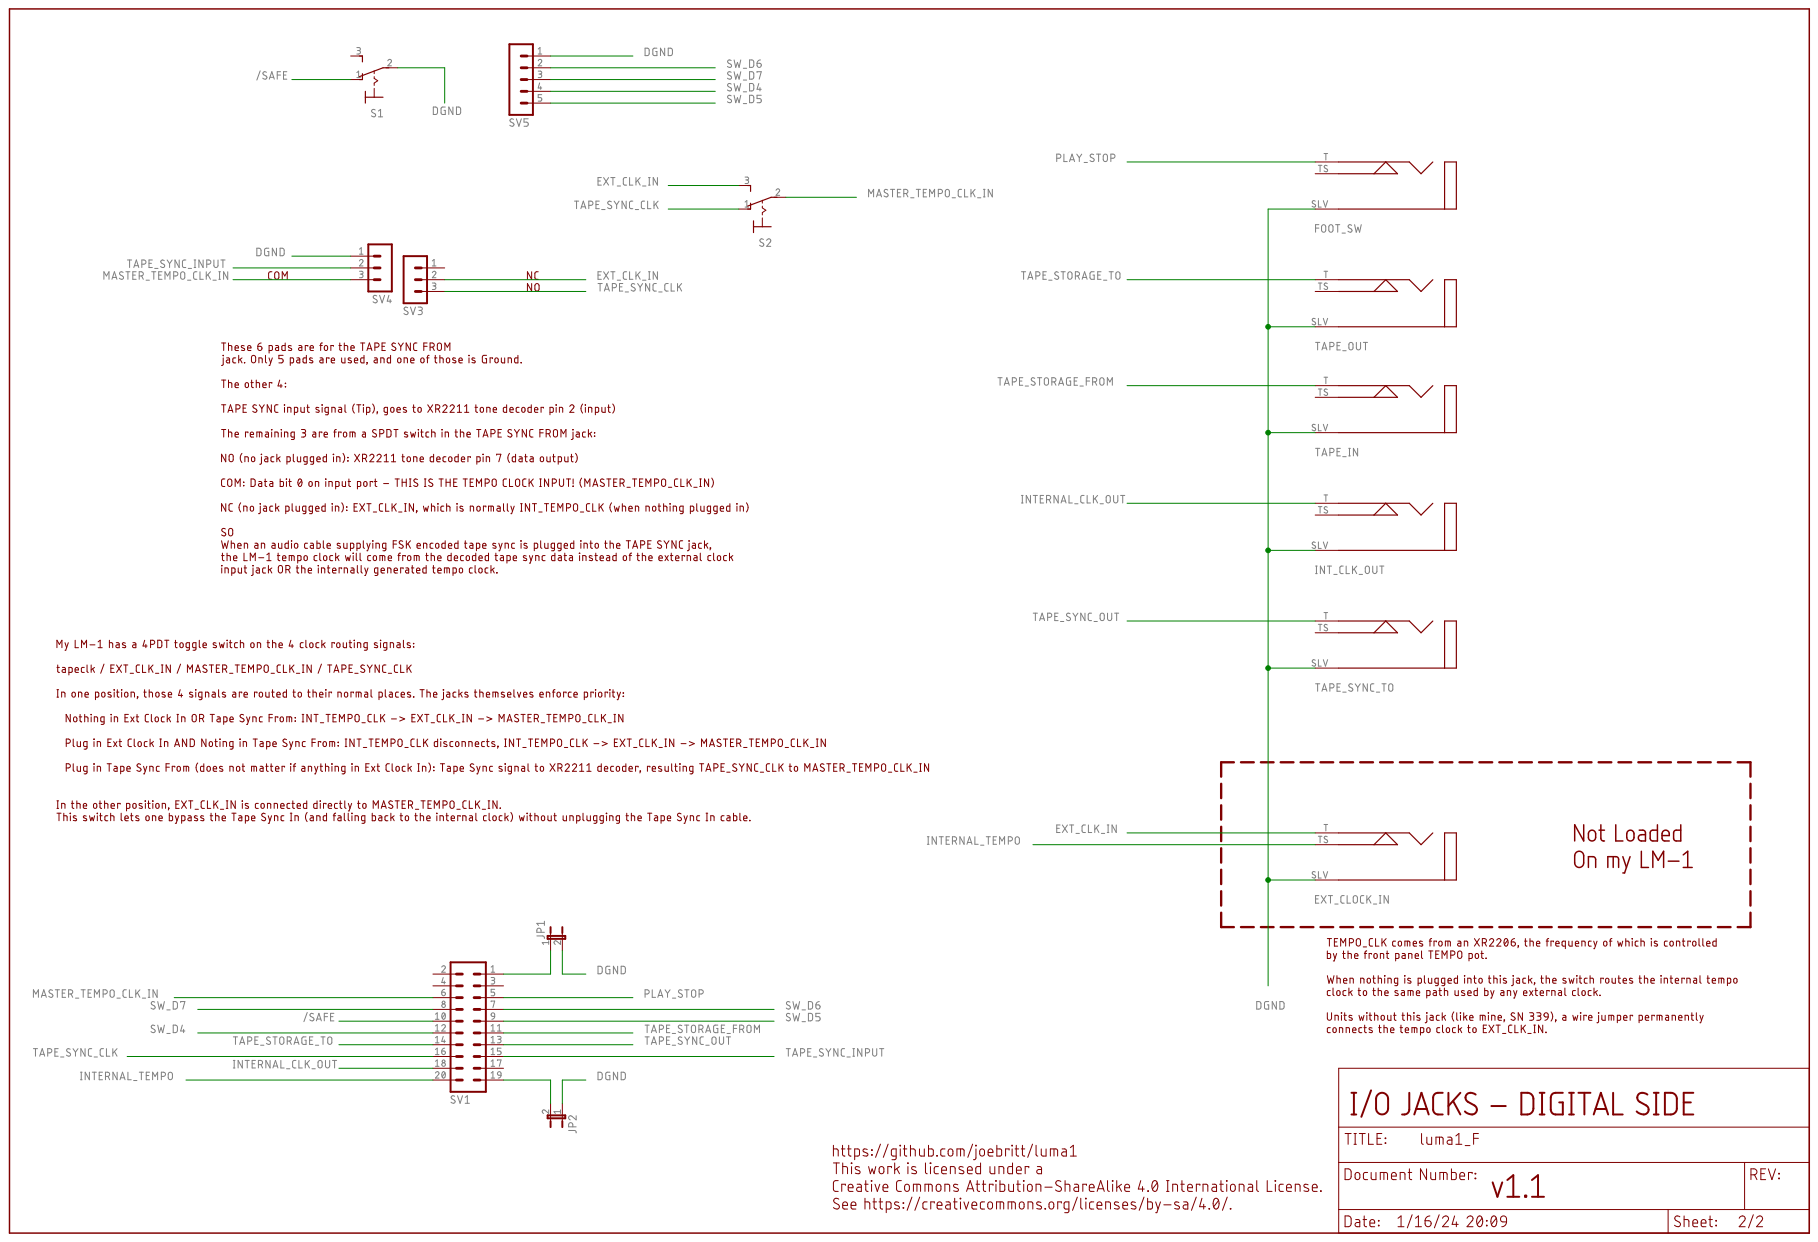
[picture p30: page 2]
