joebritt/luma1/Schematics/luma-1_release_17Jan2024/luma1_filter_2pot.pdf

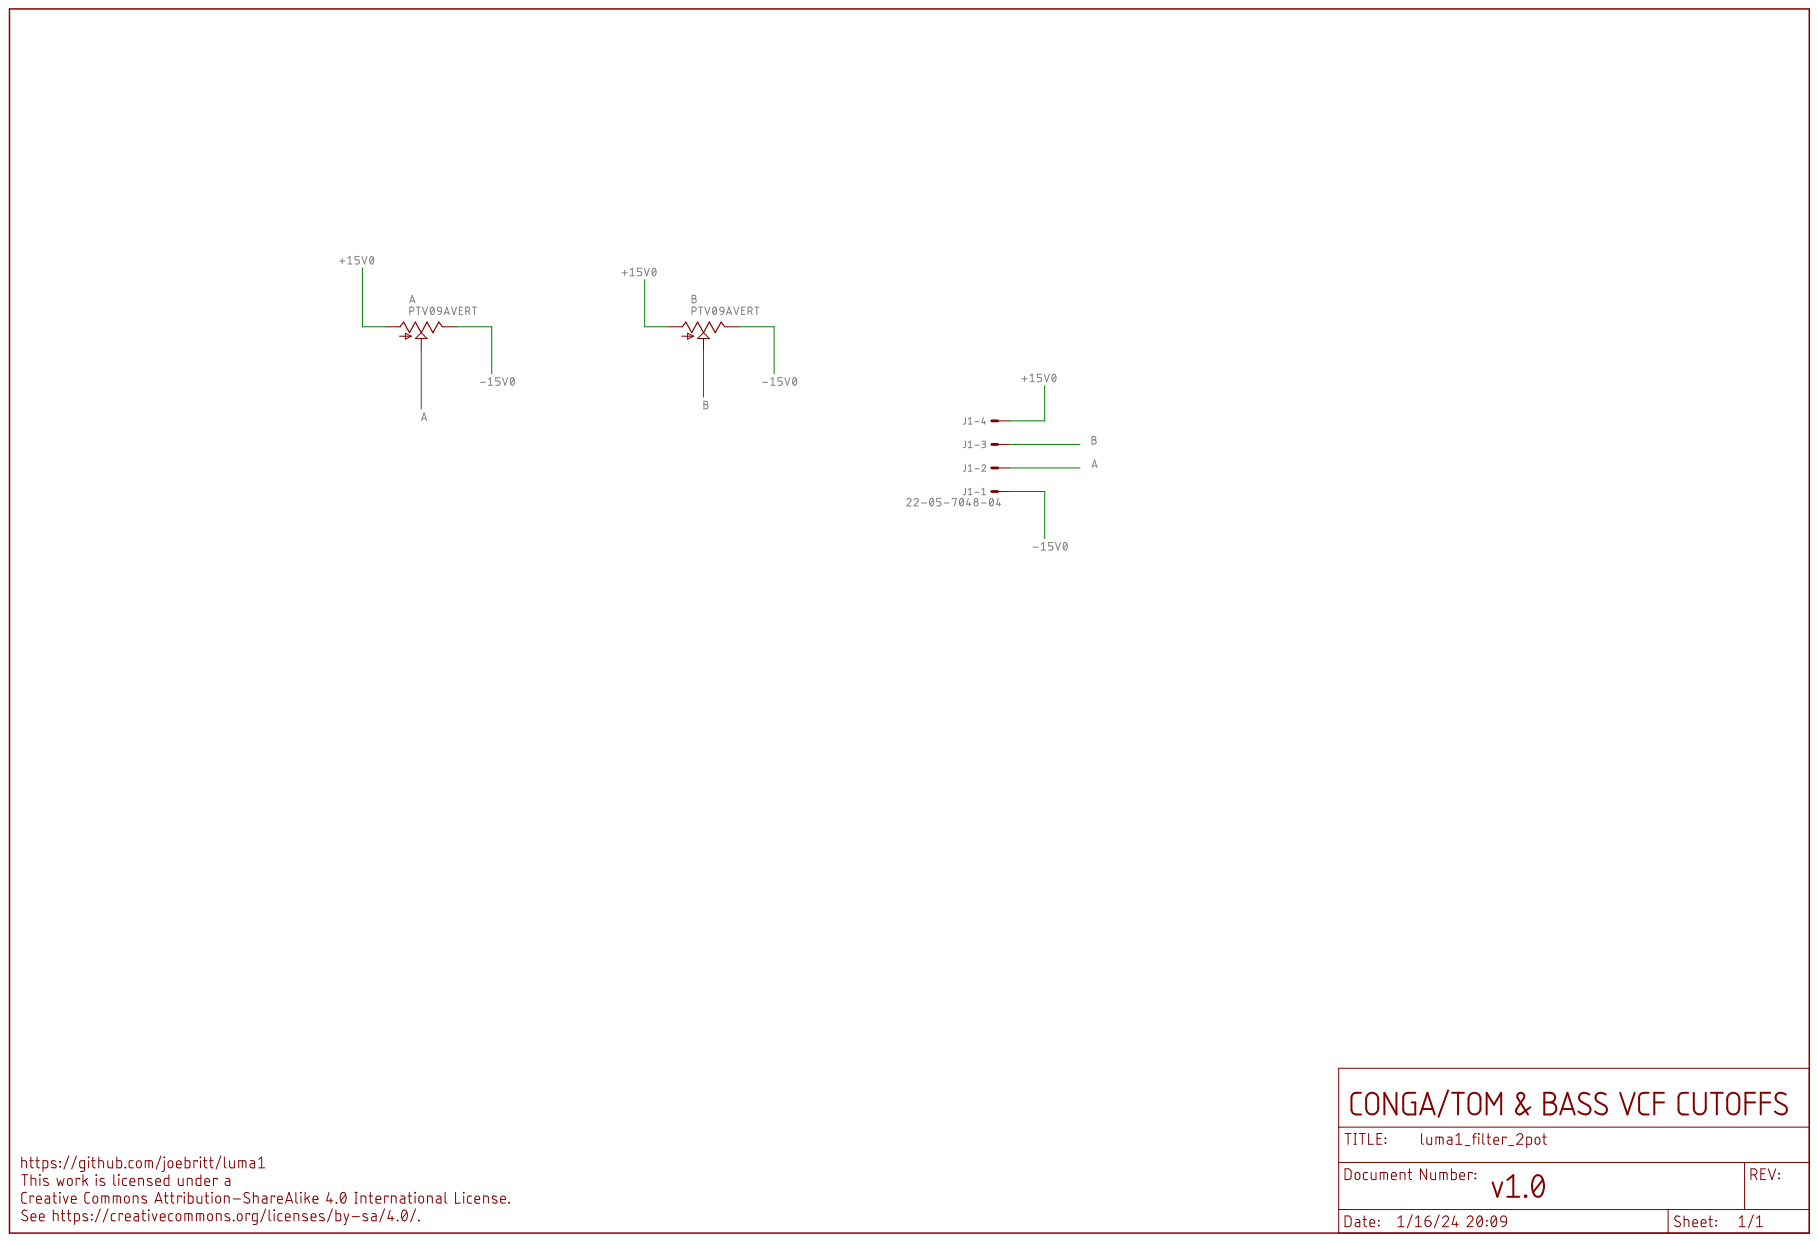
[picture p31: page 1]
