joebritt/luma1/Schematics/luma-1_release_17Jan2024/luma1_voice1.pdf

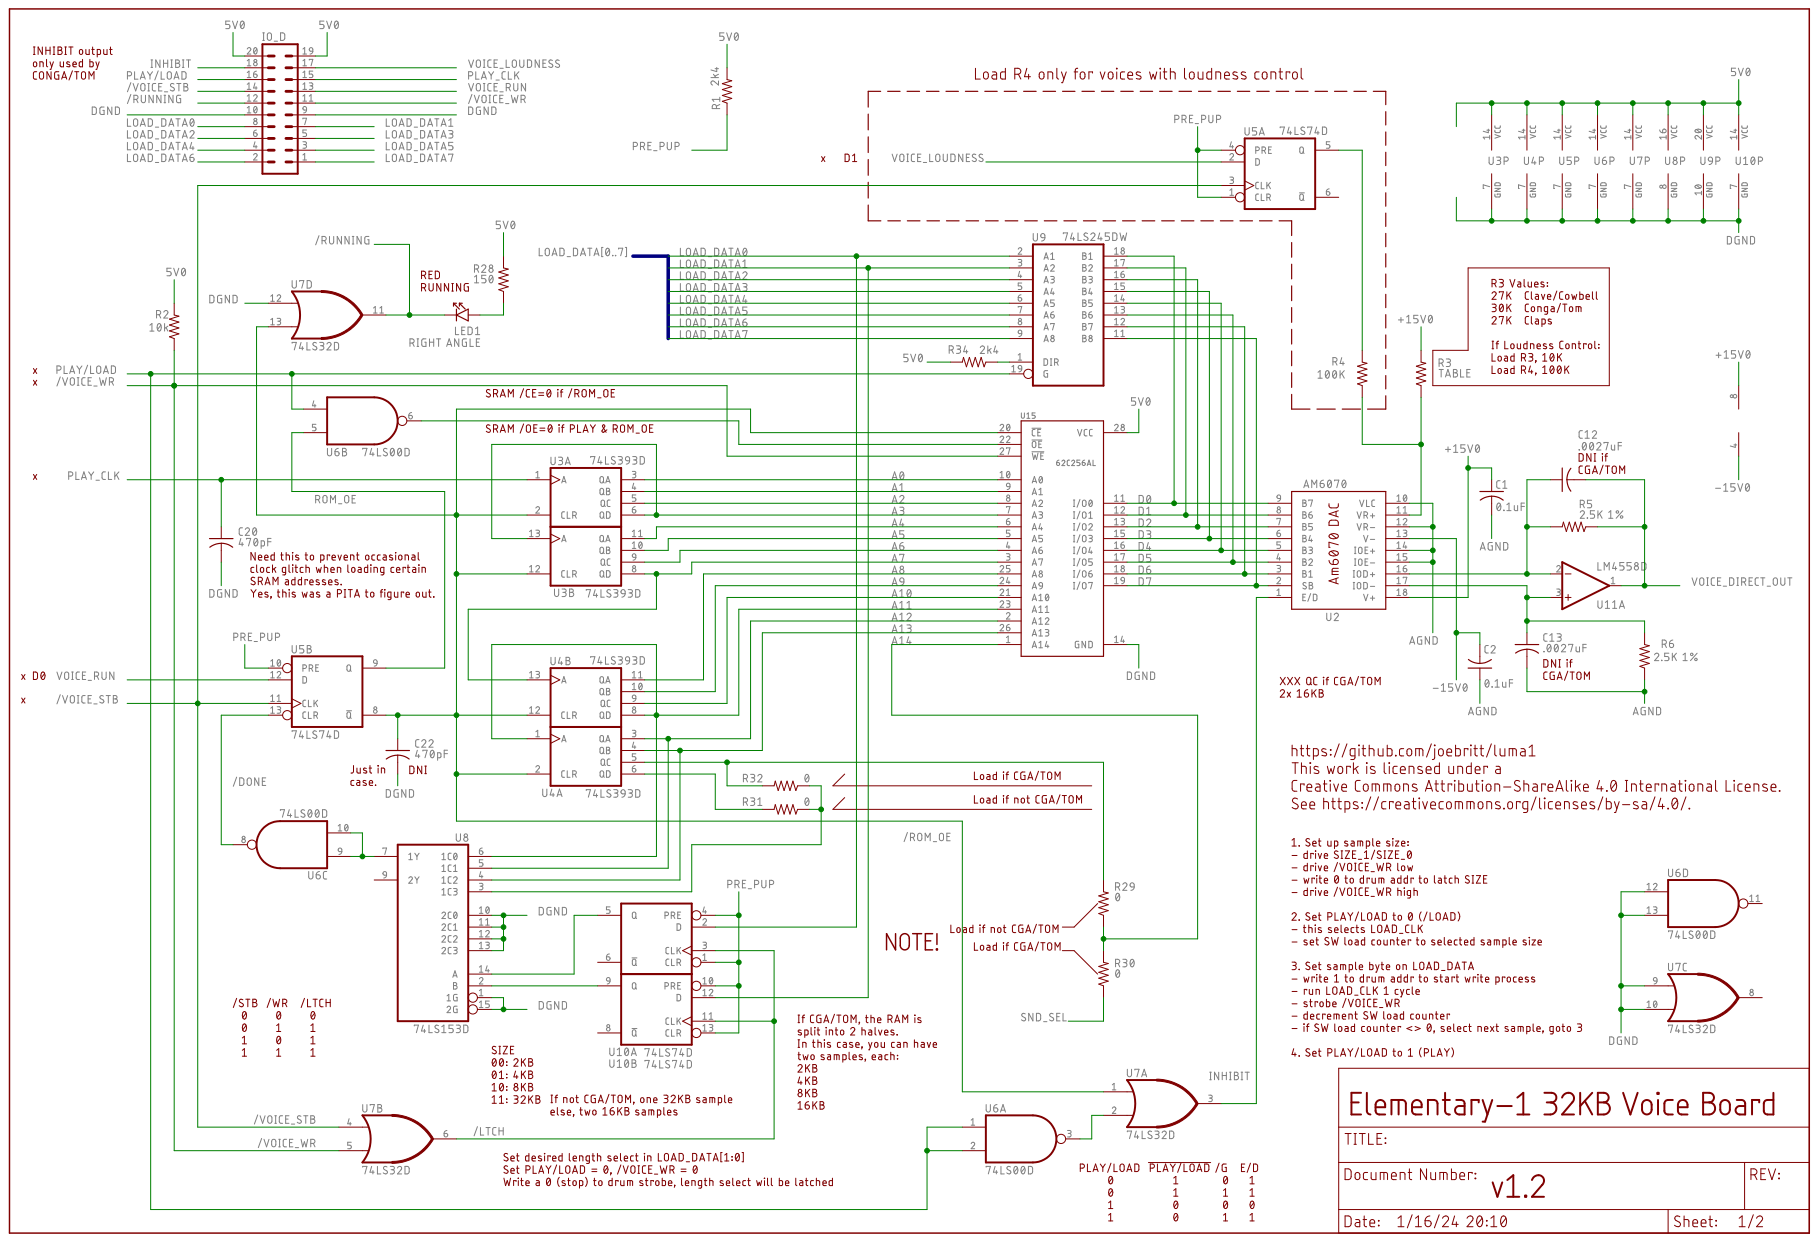
[picture p32: page 1]

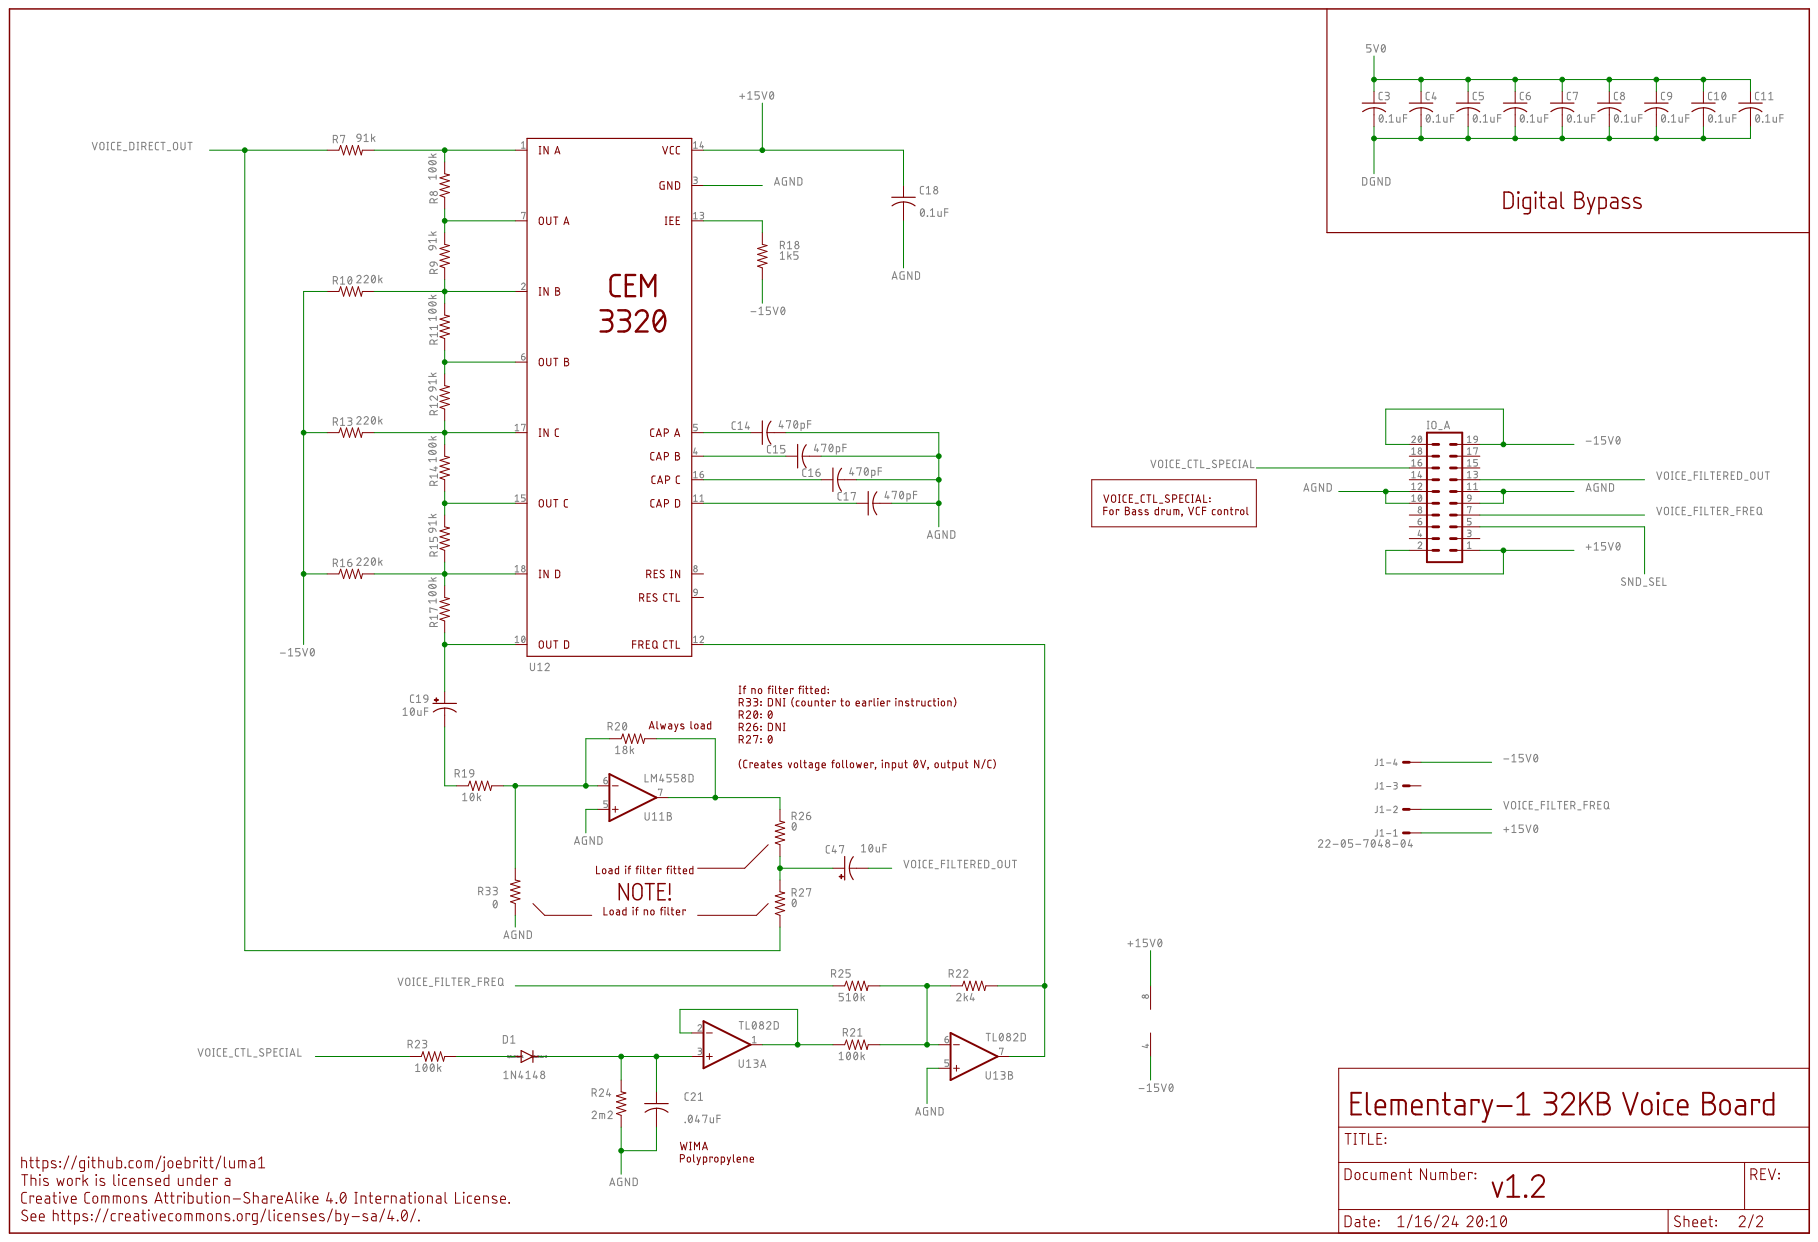
[picture p33: page 2]
