joebritt/luma1/Schematics/luma-1_release_17Jan2024/luma1_voice2.pdf

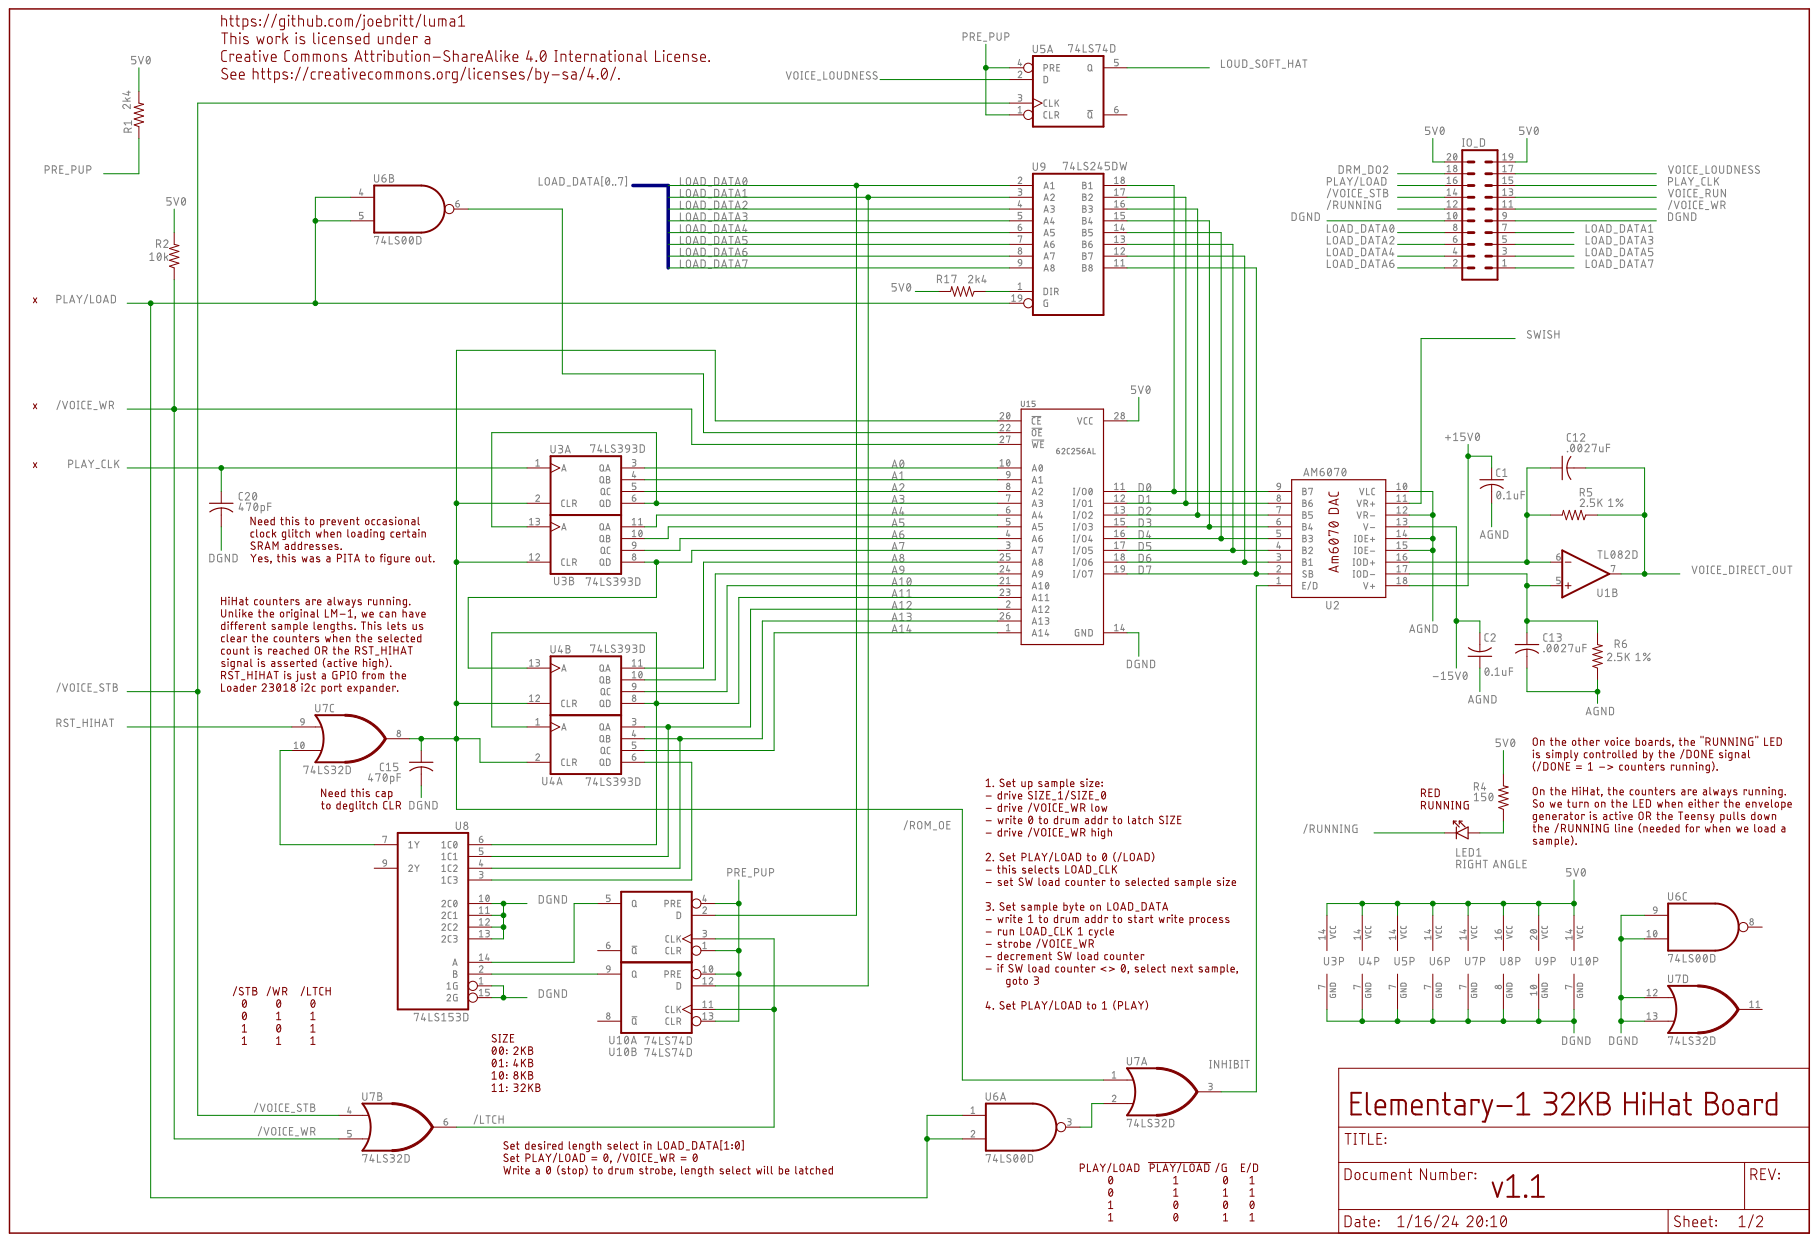
[picture p34: page 1]

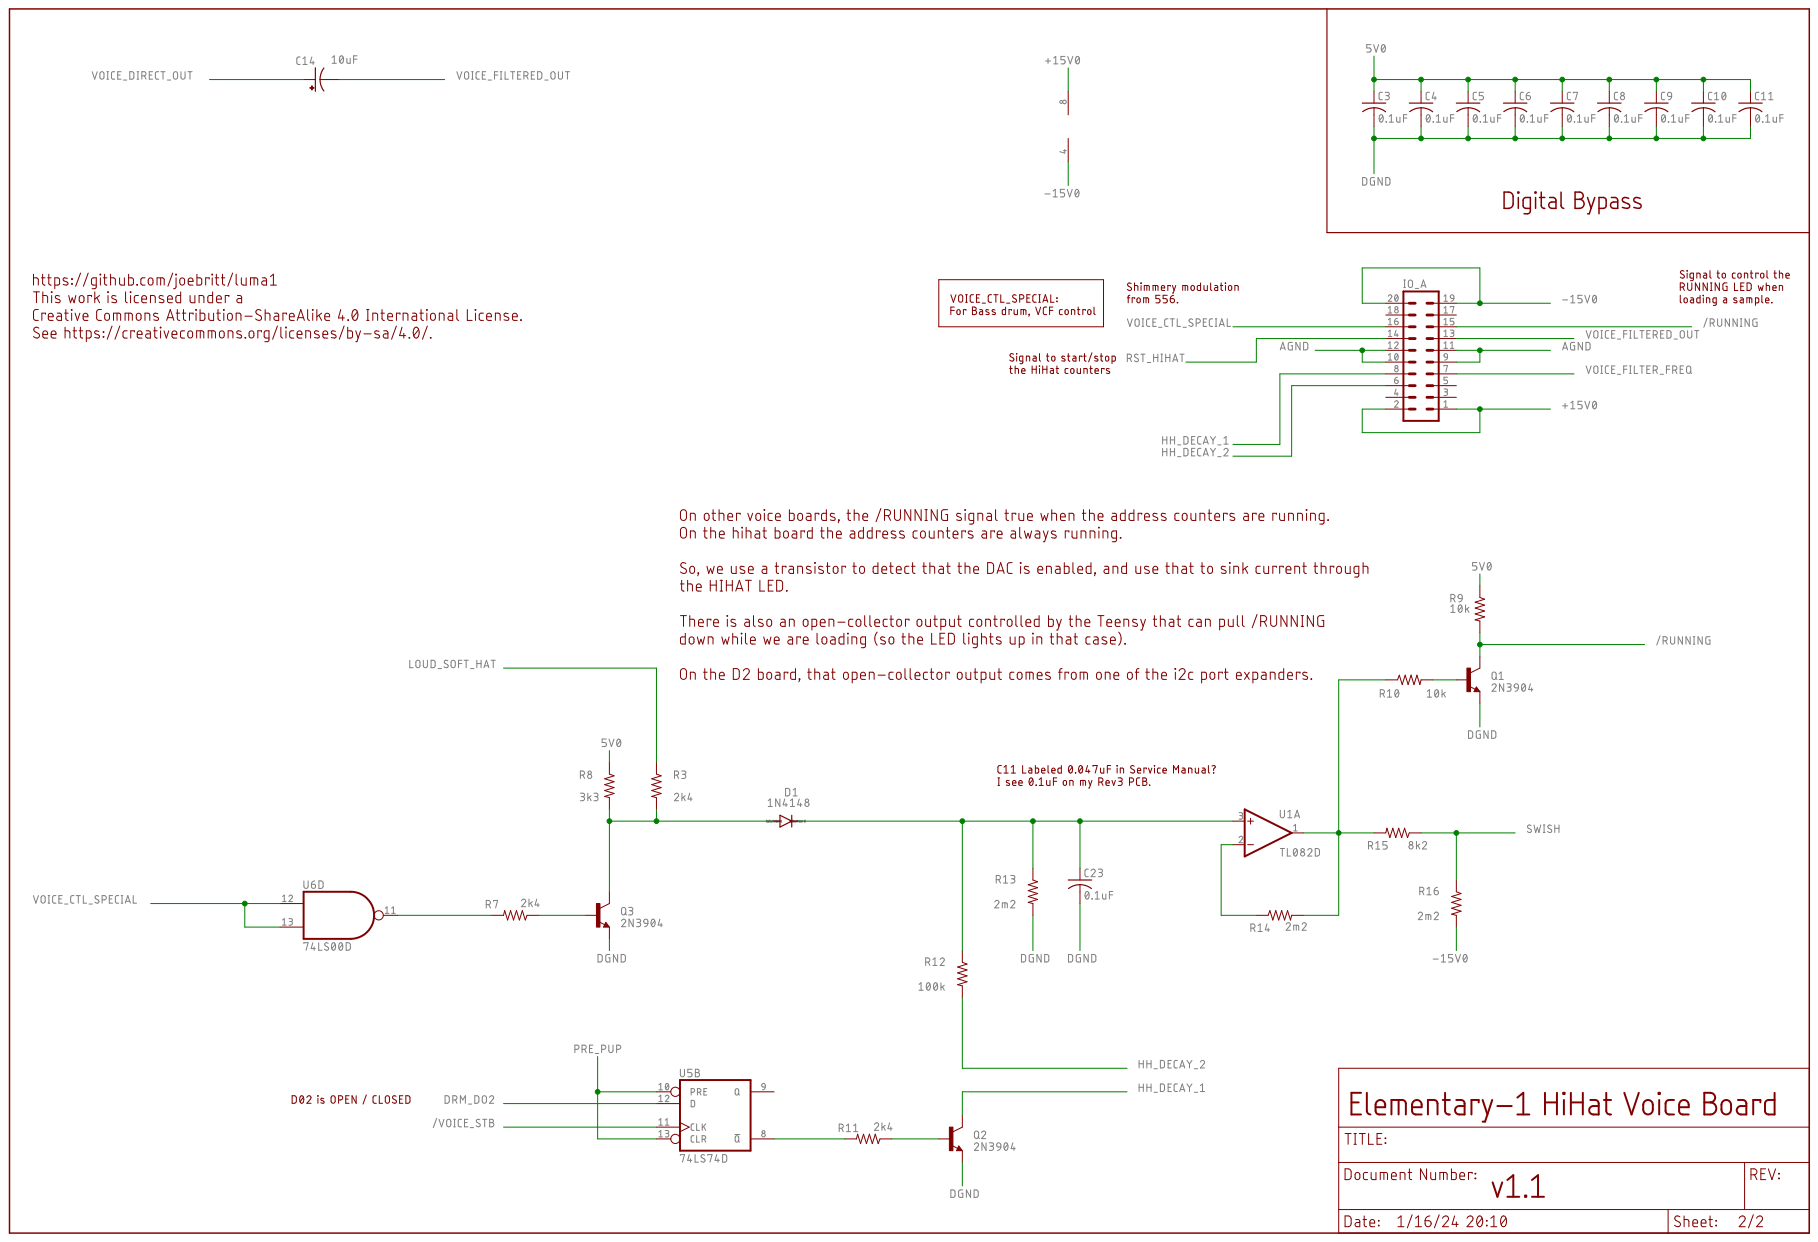
[picture p35: page 2]
