joebritt/luma1/TeensyCode/Luma1/LM1_RAM.h

uint8_t factory_ram[8*1024] = {
0x01,0x00,0x00,0x01,0x00,0x16,0x0a,0x0b, 0x80,0x00,0x00,0x00,0x00,0x00,0x00,0x00,
0x00,0x00,0x00,0x00,0x00,0x00,0xb0,0x00, 0x00,0x00,0xf5,0xcd,0x86,0x16,0x21,0x00,
0xed,0xa4,0x0a,0xed,0xa4,0x17,0x00,0xeb, 0xa4,0x01,0x0c,0x00,0x16,0x00,0x08,0xa5,
0x0c,0xff,0xbf,0x00,0x00,0x5a,0x00,0x00, 0x00,0x10,0x02,0x80,0x80,0x00,0x01,0xe6,
0x32,0xa0,0xb0,0x16,0xcd,0x82,0x02,0xc6, 0xd2,0x80,0xf5,0xa0,0x3b,0xfe,0x28,0x32,
0xa0,0x3c,0xfe,0x28,0x32,0xa0,0x80,0x3b, 0x32,0xa0,0xf5,0xcd,0x86,0x16,0x71,0x82,
0xbc,0x1b,0x71,0x82,0x71,0x82,0x71,0x82, 0x01,0x07,0x08,0xa5,0x1d,0x82,0x21,0x82,
0x17,0x28,0xdd,0x91,0x99,0x82,0xd4,0x85, 0xb6,0x84,0x58,0x80,0x80,0xfe,0x68,0xa4,
0x88,0xa4,0xb8,0xa4,0xe4,0xa4,0x08,0xa5, 0x4c,0xa5,0x7c,0xa5,0xe5,0xa5,0x35,0xa6,
0x7d,0xa6,0xbb,0xa6,0xfe,0xa6,0x24,0xa7, 0x5e,0xa7,0xbe,0xa7,0xde,0xa7,0x04,0xa8,
0x4a,0xa8,0x62,0xa8,0x92,0xa8,0xba,0xa8, 0xe2,0xa8,0x14,0xa9,0x22,0xa9,0x3c,0xa9,
0x58,0xa9,0x58,0xa9,0x58,0xa9,0x58,0xa9, 0x58,0xa9,0x58,0xa9,0x58,0xa9,0x58,0xa9,
0x58,0xa9,0x58,0xa9,0x58,0xa9,0x58,0xa9, 0x58,0xa9,0x58,0xa9,0x58,0xa9,0x58,0xa9,
0x58,0xa9,0x58,0xa9,0x58,0xa9,0x58,0xa9, 0x58,0xa9,0x58,0xa9,0x58,0xa9,0x58,0xa9,
0x58,0xa9,0x58,0xa9,0x58,0xa9,0x58,0xa9, 0x58,0xa9,0x58,0xa9,0x58,0xa9,0x58,0xa9,
0x58,0xa9,0x58,0xa9,0x58,0xa9,0x58,0xa9, 0x58,0xa9,0x58,0xa9,0x58,0xa9,0x58,0xa9,
0x58,0xa9,0x58,0xa9,0x58,0xa9,0x58,0xa9, 0x58,0xa9,0x58,0xa9,0x58,0xa9,0x58,0xa9,
0x58,0xa9,0x58,0xa9,0x58,0xa9,0x58,0xa9, 0x58,0xa9,0x58,0xa9,0x58,0xa9,0x58,0xa9,
0x58,0xa9,0x58,0xa9,0x58,0xa9,0x58,0xa9, 0x58,0xa9,0x58,0xa9,0x58,0xa9,0x58,0xa9,
0x58,0xa9,0x58,0xa9,0x58,0xa9,0x58,0xa9, 0x58,0xa9,0x58,0xa9,0x58,0xa9,0x58,0xa9,
0x58,0xa9,0x58,0xa9,0x58,0xa9,0x58,0xa9, 0x52,0x00,0x01,0x02,0x03,0x04,0x05,0x06,
0x07,0x08,0x09,0x0a,0x0b,0x0c,0x0d,0x0e, 0x0f,0x10,0x11,0x12,0x13,0x14,0x15,0x16,
0x17,0x18,0xab,0xab,0xab,0xab,0xab,0xab, 0xab,0xab,0xab,0xab,0xab,0xab,0xab,0xab,
0xab,0xab,0xab,0xab,0xab,0xab,0xab,0xab, 0xab,0xab,0xab,0xab,0xab,0xab,0xab,0xab,
0xab,0xab,0xab,0xab,0xab,0xab,0xab,0xab, 0xab,0xab,0xab,0xab,0xab,0xab,0xab,0xab,
0xab,0xab,0xab,0xab,0xab,0xab,0xab,0xab, 0xab,0xab,0xab,0xab,0xab,0xab,0xab,0xab,
0xab,0xab,0xab,0xab,0xab,0xab,0xab,0xab, 0xab,0xab,0xab,0xab,0xab,0x00,0xab,0xab,
0xab,0xab,0xab,0xab,0xab,0xab,0xab,0xab, 0xab,0xab,0xab,0xab,0xab,0xab,0xab,0xab,
0xab,0xab,0xab,0xab,0xab,0xab,0xab,0xab, 0xab,0xab,0xab,0xab,0xab,0xab,0xab,0xab,
0xab,0xab,0xab,0xab,0xab,0xab,0xab,0xab, 0xab,0xab,0xab,0xab,0xab,0xab,0xab,0xab,
0xab,0xab,0xab,0xab,0xab,0xab,0xab,0xab, 0xab,0xab,0xab,0xab,0xab,0xab,0xab,0xab,
0xab,0xab,0xab,0xab,0xab,0xab,0xab,0xab, 0xab,0xab,0xab,0xab,0xab,0xab,0xab,0xab,
0xab,0xab,0xab,0xab,0xab,0xab,0xab,0xab, 0xab,0xab,0xab,0xab,0xab,0xab,0xab,0xab,
0xab,0x00,0xab,0xab,0xab,0xab,0xab,0xab, 0xab,0xab,0xab,0xab,0xab,0xab,0xab,0xab,
0xab,0xab,0xab,0xab,0xab,0xab,0xab,0xab, 0xab,0xab,0xab,0xab,0xab,0xab,0xab,0xab,
0xab,0xab,0xab,0xab,0xab,0xab,0xab,0xab, 0xab,0xab,0xab,0xab,0xab,0xab,0xab,0xab,
0xab,0xab,0xab,0xab,0xab,0xab,0xab,0xab, 0xab,0xab,0xab,0xab,0xab,0xab,0xab,0xab,
0xab,0xab,0xab,0xab,0xab,0xab,0xab,0xab, 0xab,0xab,0xab,0xab,0xab,0xab,0xab,0xab,
0xab,0xab,0xab,0xab,0xab,0xab,0xab,0xab, 0xab,0xab,0xab,0xab,0xab,0xab,0xab,0xab,
0xab,0xab,0xab,0xab,0xab,0x00,0xab,0xab, 0xab,0xab,0xab,0xab,0xab,0xab,0xab,0xab,
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
};
