joebritt/luma1/TeensyCode/Luma1/LM_OLED_Images.h

#define CLOCKS_FRAME_COUNT 8
#define CLOCKS_FRAME_WIDTH 16
#define CLOCKS_FRAME_HEIGHT 16

/* Piskel data for "New Piskel" */

static const uint32_t clock_icons[8][256] = {
{
0x00000000, 0x00000000, 0x00000000, 0x00000000, 0x00000000, 0xff000000, 0xff000000, 0xff000000, 0xff000000, 0xff000000, 0x00000000, 0x00000000, 0x00000000, 0x00000000, 0x00000000, 0x00000000,
0x00000000, 0x00000000, 0x00000000, 0xff000000, 0xff000000, 0xff000000, 0xff000000, 0xff000000, 0xff000000, 0xff000000, 0xff000000, 0xff000000, 0x00000000, 0x00000000, 0x00000000, 0x00000000,
0x00000000, 0x00000000, 0xff000000, 0xff000000, 0xff000000, 0x00000000, 0x00000000, 0x00000000, 0x00000000, 0x00000000, 0xff000000, 0xff000000, 0xff000000, 0x00000000, 0x00000000, 0x00000000,
0x00000000, 0xff000000, 0xff000000, 0xff000000, 0x00000000, 0x00000000, 0x00000000, 0xff000000, 0x00000000, 0x00000000, 0x00000000, 0xff000000, 0xff000000, 0xff000000, 0x00000000, 0x00000000,
0x00000000, 0xff000000, 0xff000000, 0x00000000, 0x00000000, 0x00000000, 0x00000000, 0xff000000, 0x00000000, 0x00000000, 0x00000000, 0x00000000, 0xff000000, 0xff000000, 0x00000000, 0x00000000,
0xff000000, 0xff000000, 0x00000000, 0x00000000, 0x00000000, 0x00000000, 0x00000000, 0xff000000, 0x00000000, 0x00000000, 0x00000000, 0x00000000, 0x00000000, 0xff000000, 0xff000000, 0x00000000,
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
0x00000000, 0x00000000, 0x00000000, 0x00000000, 0x00000000, 0x00000000, 0x00000000, 0x00000000, 0x00000000, 0x00000000, 0x00000000, 0x00000000, 0x00000000, 0x00000000, 0x00000000, 0x00000000
}
};
