joebritt/luma1/(commit log)

2024-01-17 Create folder for Teensy code.
2024-01-17 First upload of Luma-1 Teensy code.
    This runs on a Teensy 4.1.
    Have fun!
2024-01-17 Luma-1 Drum Computer PDF schematics
2024-01-21 Fixed bug that could corrupt RAM during sysex transfers
    Some old sysex handling code could access Z-80 address space without taking the bus first.
    [LM_Beep.ino, LM_MIDI.ino, Luma1.ino]
2024-01-29 MIDI Clock Fixes
    Some hardware sequencers send MIDI clock continuously.
    Qualify MIDI clock with MIDI Start/Stop.
    Some hardware sequencers send MIDI Continue instead of MIDI Start. Honor MIDI Continue as MIDI Start, at least for now. Eventually we should be able to restart the Luma-1 sequencer on MIDI Start.
    [LM_MIDI.h, LM_MIDI.ino, Luma1.ino]
2024-01-29 Fix off-by-1 in Sysex sample size
    [LM_MIDI.ino]
2024-02-04 MIDI Clock Fixes
    Changed the way MIDI clock is converted into the Tempo Clock pulses for the Z-80.
    Simpler approach than before. Verified with oscilloscope and by recording simple pattern into Ableton Live.
    See LM_MIDI.ino for most of the changes.
    [LM_EPROM_Reader.ino, LM_MIDI.h, LM_MIDI.ino, Luma1.ino]
2024-02-04 fix KEY_MENU warning
    renamed constant to KEY_MENU_LUMA
    [LM_DebugCmds.ino, LM_LUI.ino, LM_LUI_Actions.ino, LM_Z80Keys.h, Luma1.ino]
2024-02-04 Fix warnings
    Fixed many const char * / char * warnings.
    More fixes to come.
    [LM_Beep.h, LM_Beep.ino, LM_DebugCmds.ino, LM_EEPROM.ino, LM_LUI.ino, LM_LUI_Actions.ino, LM_LUI_Info.ino, LM_MIDI.ino]
2024-02-05 Fix warnings
    DIN5 sysex handler has different method signature than USB sysex handler.
    This is also why the "last" flag was not working as expected.
    The hack to work around the other behavior is still valid.
    Tested on my Luma-1.
    [LM_MIDI.ino]
2024-02-05 Fixed warning
    made array index int, not byte.
    even though byte is plenty. :-)
    [LM_OLED.ino]
2024-02-05 Fix some warnings.
    There's a global working buf referenced as a uint8_t*, used with some things that want char*.
    [LM_SDCard.ino]
2024-02-05 Fix warnings
    uint8_t vs. char
    [LM_Voices.ino]
2024-02-05 Fix warning
    Can't have an elapsedMillis in a packed struct
    [LM_MIDI.ino]
2024-02-05 MIDI Soft Thru On/Off Control
    Added new Menu command 86, which lets you turn MIDI Soft Thru on and off.
    This is a persistent setting, stored to EEPROM.
    It only applied to the DIN5 connectors, there is no MIDI Soft Thru for USB.
2024-02-05 Fixed build.
    Was referencing something that isn't ready / checked in yet.
    [LM_MIDI.ino]
2024-02-19 MIDI Start/Stop support
    Honor MIDI Start/Stop. To the Z-80, these messages (and MIDI Continue) look like a press of the Start/Stop footswitch (same as the Play/Stop button).
2024-03-01 Fix intermittent pop on MIDI drum triggers
    Honor the current state of the D802 control register, which controls drum trigger access and (among other things) the software Beep generator.
    [LM_Z80Bus.ino, Luma1.ino]
2024-03-07 Fix fan enable bug introduced with pop fix
    Fan enable bits in same register as Beep bit, which was causing pop on MIDI drum trigger.
    Properly save and restore state so I don't break fan enabling. :-)
    [LM_Voices.ino, LM_Z80Bus.ino]
2024-03-10 MIDI Start/Stop changes
    Hopefully fix the occasional crash when handling MIDI Start/Stop. I do 3 z-80 bus accesses, and was very briefly (~80ns) deasserting /BR between the first and second.
    Hopefully fixed the occasional z-80 sequencer wedge when processing MIDI Stop. For MIDI Clock sources that are gated by MIDI Start/Stop (like Ableton Live), stopping the z-80 sequencer just as the clock was stopping would sometimes leave it in a bad state. Not crashed, just half-stopped. Now I always "skid" the MIDI clock to a stop by inserting a few fake tempo clock pulses after handling the MIDI Stop.
    Finally, added a new front panel command to let the user toggle off/on whether Luma-1 honors MIDI Star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
    [LM_LUI.ino, LM_LUI_Info.ino, LM_MIDI.h, LM_MIDI.ino, LM_Z80Patches.h, LM_Z80Patches.ino, Luma1.ino]
2024-03-31 MIDI Clock Sync and EPROM reading improvements
    The LM-1 side of Luma can miss clock sync pulses, especially if it is "busy" (handling lots of events or key inputs while playing).
    Incoming MIDI messages must be polled.
    More aggressively poll, especially when the LM-1 sequencer is running.
    Modify the OLED blit loop to push less data (which takes time over i2c) and check more aggressively for incoming MIDI messages while that is happening.
    Lower the OLED refresh rate while the LM-1 sequencer is running.
    Finally, make the EPROM reading code more robust.
2024-03-31 Menu option 87 for MIDI Start/Stop Enable
    New Menu option 87 to control whether Luma-1 honors MIDI Start/Stop messages.
    This is also available with shortcut Menu - ON/OFF.
    Now persists across reboots.
    [LM_EEPROM.h, LM_EEPROM.ino, LM_LUI.ino, LM_MIDI.ino, Luma1.ino]
2024-03-31 Fixes for Pattern Load/Save (Menu 02/03)
    - Fixed issue where saving a bank of Patterns (Menu 03) into an SD Card bank that already contained a RAM_IMAGE file would not overwrite that file.
    - RAM_IMAGE files now end with a 4-digit number that monotonically increases up to 9999, then wraps.
    [LM_EEPROM.h, LM_EEPROM.ino, LM_SDCard.ino, Luma1.ino]
2024-04-07 Fix problems saving voices, prebuilt 0.932
    If there are files in a voice bank directory when saving, remove them. There should be only 1 voice file in each voice directory.
    Added prebuilt 0.932.
    [LM_EPROM_Reader.ino, LM_Voices.ino, Luma1.ino]
2024-05-05 Prebuilt v0.933, Load last voice bank at boot, fix some bugs
    We used to always load bank 00 at boot. Now we load the last bank the user loaded.
    Mac OSX puts hidden files like ".DS_Store" in some directories. This could screw up voice loading. Now ignore any file that starts with '.'
    Now preserve voice bank name file (BANKNAME.TXT) when loading and saving voice banks.
    [LM_LUI_Actions.ino, LM_LUI_Info.ino, LM_Voices.h, LM_Voices.ino, Luma1.ino]
2024-05-05 Fix problem saving modified voices back to SD card
    Ugh, dumb bug that made updated STAGING voice files (like, loaded with the Luma Tool) not get copied properly when using MENU 02 to store a voice bank.
    [LM_MIDI.ino, LM_Voices.h, LM_Voices.ino, Luma1.ino]
2024-06-14 Fix Menu 87 (MIDI Start Enable), added Prebuilt 0.935
    Needed to check if we are in "ignore MIDI Start" mode when receiving MIDI Clock.
    [LM_MIDI.ino, Luma1.ino]
2024-06-25 Improved MIDI Clock sync
    NOTE: Use this with MENU 87 (MIDI Start Enable) set to disabled!
    You will need to manually arm Luma-1 before playing.
    Set rear switch to MIDI CLOCK.
    Select pattern you wish to play.
    Hit PLAY/STOP, light will come on but it won't play yet.
    Send MIDI Start and MIDI Clock, Luma-1 will start playing with tempo set by MIDI Clock tempo.
    [LM_MIDI.h, LM_MIDI.ino, LM_Z80Patches.ino, Luma1.ino]
2024-07-01 SD card / voice loading cleanup, prep for bank load/store
    Moved more out of LM_Voices -> LM_SDCard.
    Generalized some SD card code.
    Keep track of which bank # was last loaded into STAGING, and show it on the bank info screen.
2024-07-15 Bug fixes, added way to play soft notes w/o MIDI velocity
    fixed: DIN-5 OMNI mode not working. USB OMNI was OK.
    fixed: restore Soft Thru setting at boot.
    fixed: MENU 80 display problems for channels > 09
    added: Parallel MIDI notes for soft sounds to enable triggering soft sounds w/o MIDI velocity. There is a parallel mapping of notes 2 octaves down which will trigger soft versions of corresponding sounds when available. For example, you can send a C1 with vel 127 or 63 to trigger the loud and soft BASS drum, respectively. With this new change, you can send C1 with vel 127 to trigger the loud BASS drum and now C-1 with vel 127 to trigger the soft BASS drum.
    There is a new MENU 88 to select whe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
    [LM_EEPROM.h, LM_EEPROM.ino, LM_LUI.ino, LM_MIDI.h, LM_MIDI.ino, Luma1.ino]
2024-09-03 More sysex support for banks and names, bug fixes
    Sysex support for getting / loading voice files from / into any bank.
    Sysex support for getting / setting names.
    Sysex support for getting / setting parameters, like MIDI channel, routing, etc.
    Bug fixes.
    [LM_EEPROM.h, LM_EEPROM.ino, LM_LUI.ino, LM_LUI_Actions.ino, LM_MIDI.ino, LM_SDCard.h, LM_SDCard.ino, LM_Voices.h]
2024-09-07 Improved sysex sample transfers.
    NOTE! Recommended toolchain is Arduino 1.8.19 + Teensy 1.58.
    A known issue in the Arduino/Teensy toolchain and/or libraries can result in corruption when transferring large blocks of data over USB MIDI.
    DIN5 MIDI appears to not have this issue (but is of course slower).
    For more details, see:
    https://forum.pjrc.com/index.php?threads/usbmidi-transmission-error.70288/
    [Luma1.ino]
2024-09-07 v0.941: New MENU 89 to work around sysex issue
    Some computers (like Windows machines) cannot reliably receive USB sysex data sent at full speed.
    Added MENU 89, which lets the user set how many milliseconds of delay are inserted between each 256 byte chunk of sysex data.
    The code defaults it to 50ms, which gives reliable voice sample uploading on my Lenovo T14 running Windows 10.
    I can get reliable sample uploading with it set to 0ms on my M1 MacBook Pro. That setting causes the Lenovo to corrupt some of the received sample data.
    Also added length parameter to sample sysex messages so the luma tool can sanity check the received length.
    Also bumped the version # to 0.941.
    [LM_EEPROM.h, LM_EEPROM.ino, LM_LUI.ino, LM_MIDI.h, LM_MIDI.ino, Luma1.ino]
2024-09-15 WIP for Pattern RAM read/write over sysex, Prebuilt 0.942
    Teensy code support for reading and writing Z-80 pattern RAM over sysex.
    Work in progress!
    Prebuilt v0.942
2024-09-29 Added Andrei's USB Host support
    Second-run Luma-1's have a USB host port.
    This version adds support for USB MIDI controllers to send MIDI Note On messages to trigger the drums.
    Also a minor UI fix, the fan active indicator was not drawing in the right place.
    Prebuilt v0.943 added with these changes.
    [LM_Fan.ino, LM_MIDI.ino, LM_OLED.ino, Luma1.ino]
2024-10-22 Fix bug saving RAM patterns to SD card.
    Was overwriting a filename buffer when I was checking for other files in the target directory.
    [LM_SDCard.ino, Luma1.ino]
2025-02-04 Fix MIDI out dropping notes when playing from sequencer
    Needed to buffer notes from the sequencer, they were coming quickly enough that they were overwriting the single note buffer previously used.
    That was good enough for local playing, but having several notes firing at the same time would cause all but the last one to be overwritten, and so not sent.
    [LM_DrumTriggers.h, LM_DrumTriggers.ino, LM_MIDI.ino, Luma1.ino]
